tskhvedadzee/ECE-Arcade/Gun-V2/Photos/Final-Print/IMG_3475.jpg

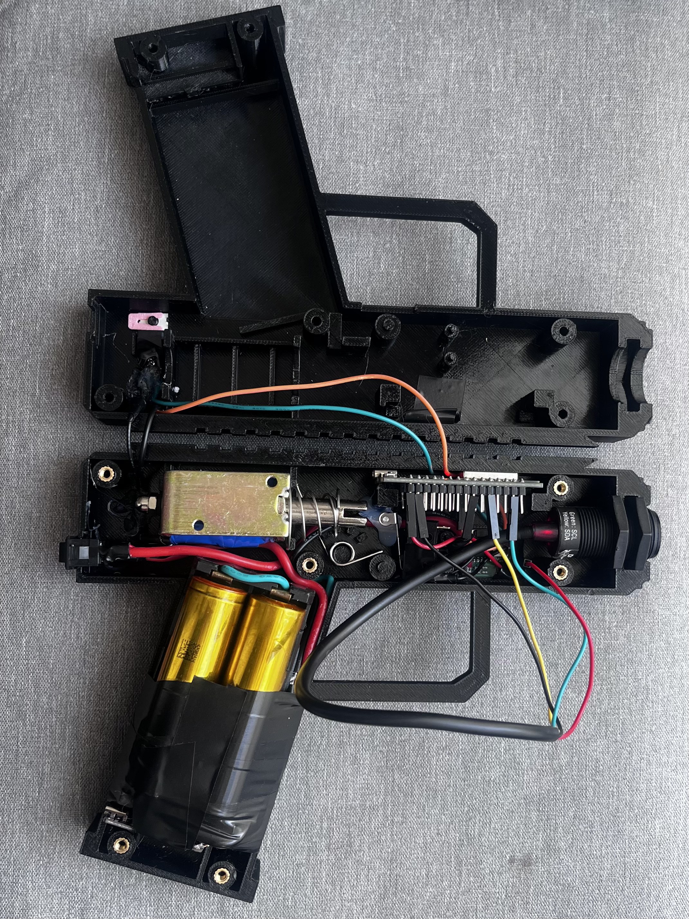
Gun-V2/Photos/Final-Print/IMG_3475.jpg
