tskhvedadzee/ECE-Arcade/README.md

-------------------   ECE Arcade   -------------------
egari raaa
