tskhvedadzee/ECE-Arcade/Cabinet/CAD/Holders/screen-IR-holder-side.SLDASM

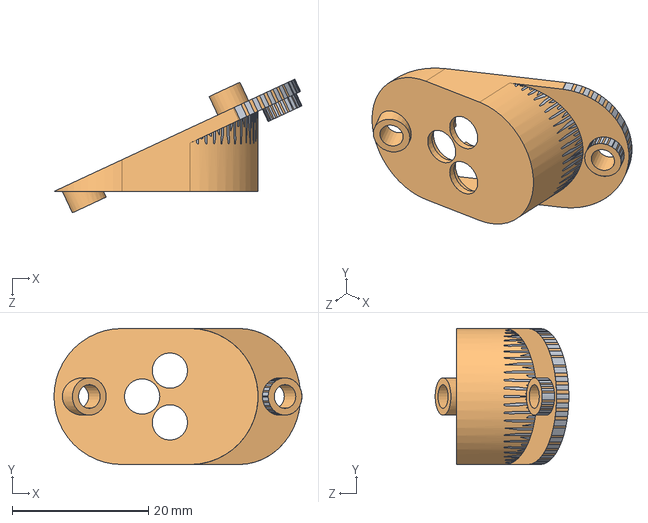
[picture p4: CAD file, 2026-09-12]
Cabinet/CAD/Holders/screen-IR-holder-side.SLDASM
36.5 x 20.0 x 19.7 mm
screen-IR-holder-side-top
screen-IR-holder-side-bottom
