tskhvedadzee/ECE-Arcade/Cabinet/CAD/Body/horn-side.SLDPRT

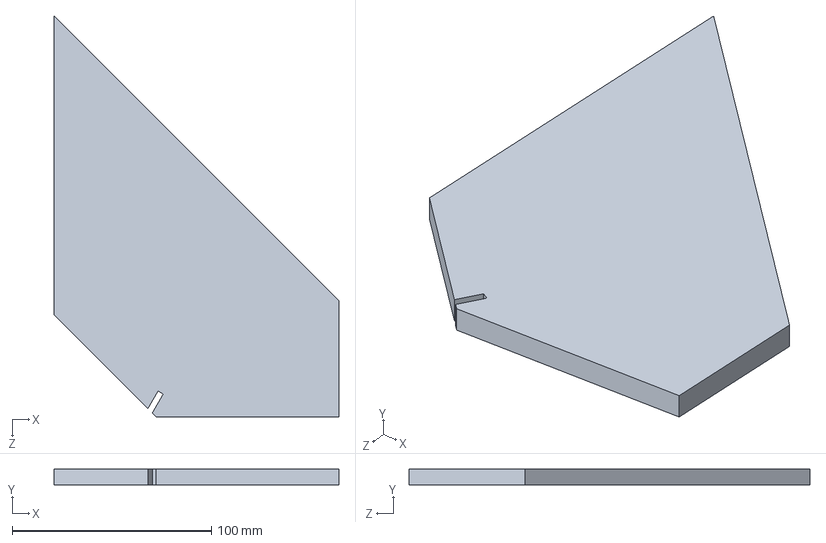
[picture p5: CAD file, 2026-09-12]
Cabinet/CAD/Body/horn-side.SLDPRT
143.1 x 8.00 x 201.3 mm
