tskhvedadzee/ECE-Arcade/Cabinet/CAD/Holders/amp_bracket_long_into_cabinet.step

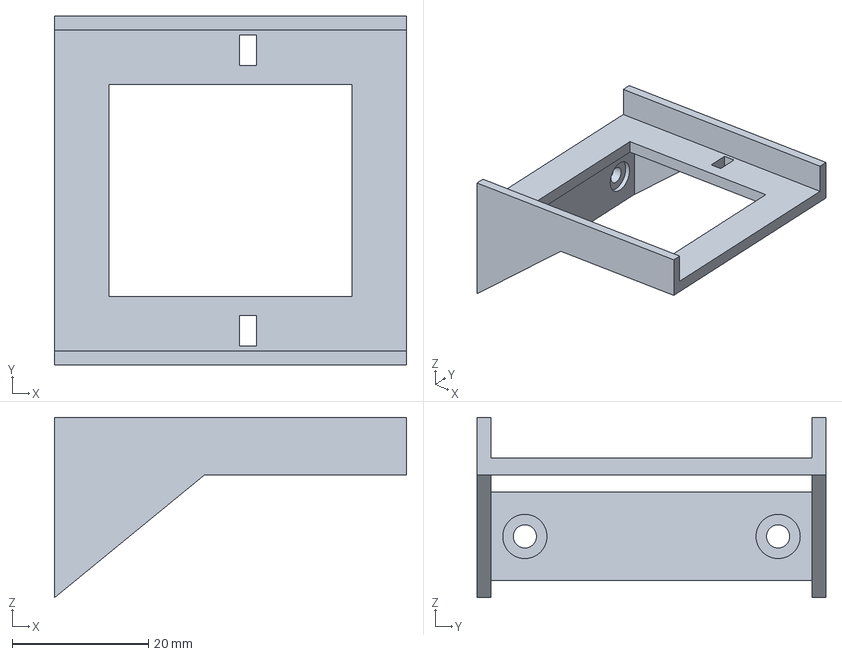
[picture p6: CAD file, 2026-10-04]
Cabinet/CAD/Holders/amp_bracket_long_into_cabinet.step
51.7 x 51.2 x 26.5 mm
