tskhvedadzee/ECE-Arcade/Cabinet/CNC/screen-front-cover-2.DXF

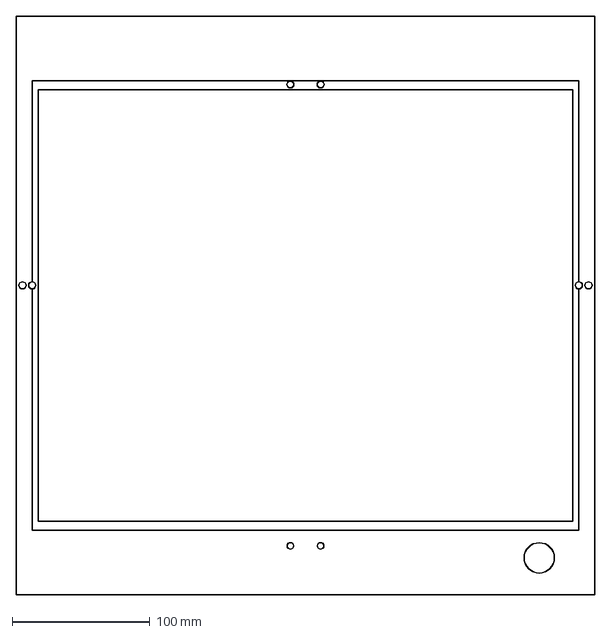
[picture p7: CAD file, 2026-09-12]
Cabinet/CNC/screen-front-cover-2.DXF
420.0 x 420.0 mm
