tskhvedadzee/ECE-Arcade/Cabinet/Laser/dxf/screen-mount.DXF

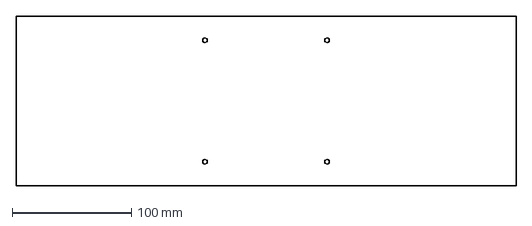
[picture p8: CAD file, 2026-08-28]
Cabinet/Laser/dxf/screen-mount.DXF
420.0 x 142.0 mm
