tskhvedadzee/ECE-Arcade/Cabinet/Printing/potentiometer-knob.3MF

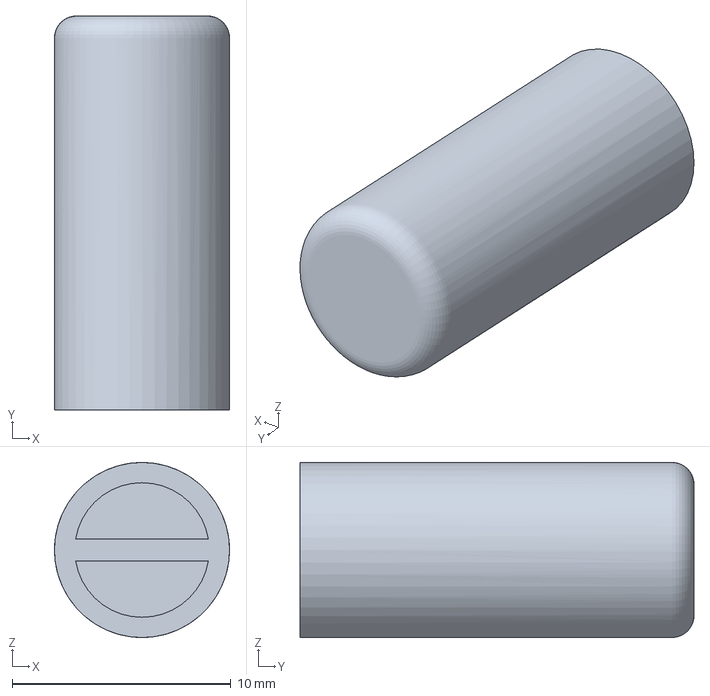
[picture p9: CAD file, 2026-09-21]
Cabinet/Printing/potentiometer-knob.3MF
8.00 x 18.0 x 8.00 mm
