tskhvedadzee/ECE-Arcade/Gun-V2/CAD/Test/test_insert.stl

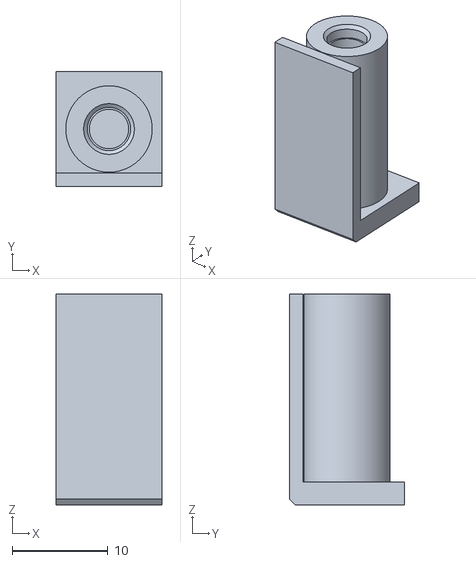
[picture p11: CAD file, 2026-09-23]
Gun-V2/CAD/Test/test_insert.stl
11.0 x 12.0 x 22.0
