tskhvedadzee/ECE-Arcade/Cabinet/CAD/Body/screen-front-cover.SLDPRT

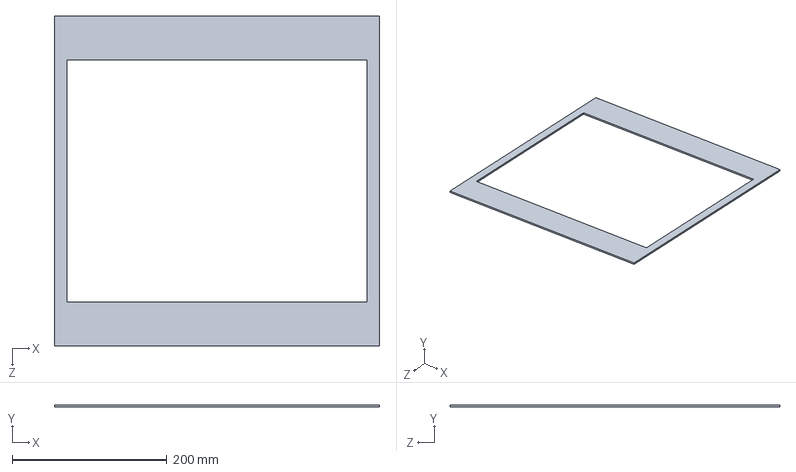
[picture p12: CAD file, 2026-09-12]
Cabinet/CAD/Body/screen-front-cover.SLDPRT
420.0 x 3.00 x 426.0 mm
