tskhvedadzee/ECE-Arcade/Cabinet/CAD/C14-power-socket-male.SLDPRT

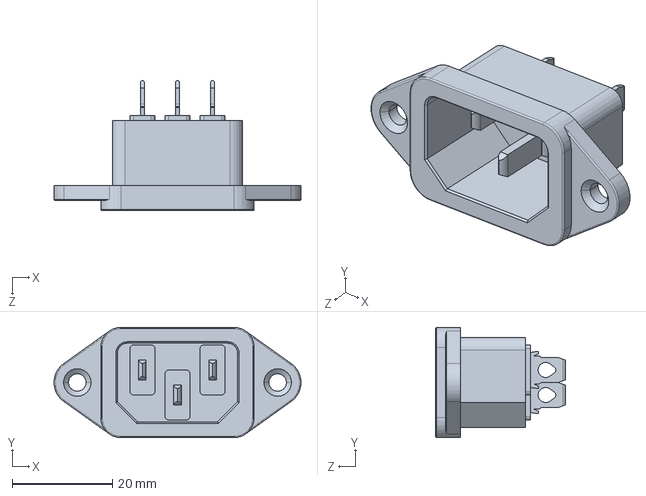
[picture p13: CAD file, 2026-08-11]
Cabinet/CAD/C14-power-socket-male.SLDPRT
49.3 x 22.0 x 26.0 mm
