tskhvedadzee/ECE-Arcade/Cabinet/CAD/Holders/amp_bracket_long_across.step

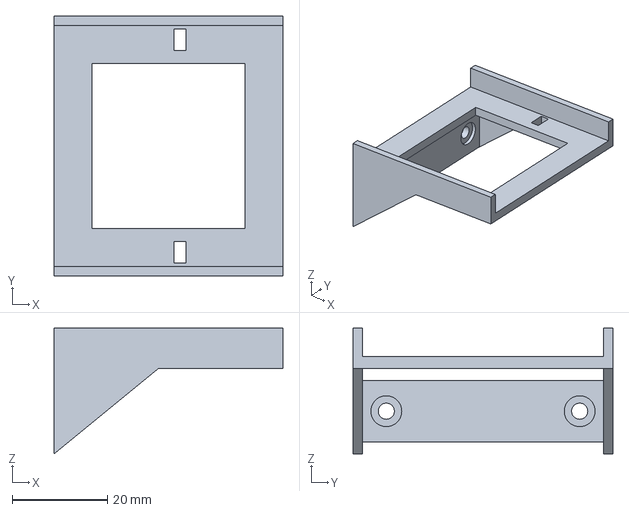
[picture p14: CAD file, 2026-10-04]
Cabinet/CAD/Holders/amp_bracket_long_across.step
48.2 x 54.7 x 26.5 mm
