tskhvedadzee/ECE-Arcade/Cabinet/CNC/front-top.SLDPRT.DXF

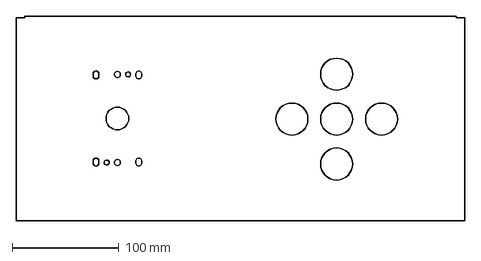
[picture p15: CAD file, 2026-08-31]
Cabinet/CNC/front-top.SLDPRT.DXF
420.0 x 191.2 mm
