tskhvedadzee/ECE-Arcade/Cabinet/Laser/dxf/bottom.DXF

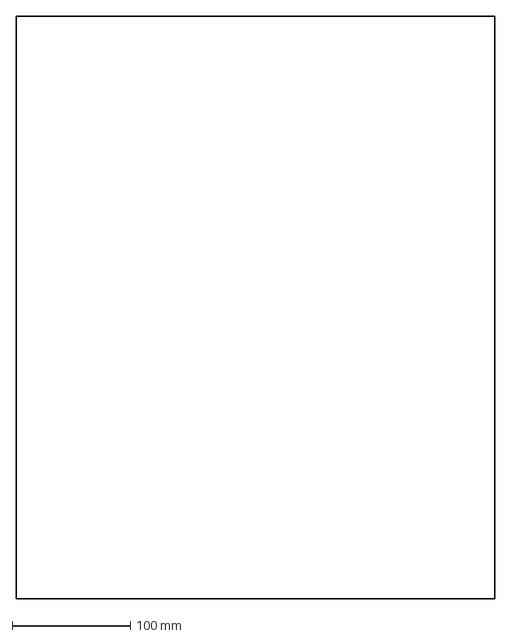
[picture p16: CAD file, 2026-08-28]
Cabinet/Laser/dxf/bottom.DXF
404.0 x 492.0 mm
