tskhvedadzee/ECE-Arcade/Cabinet/Printing/magnet-holder-outer.3MF

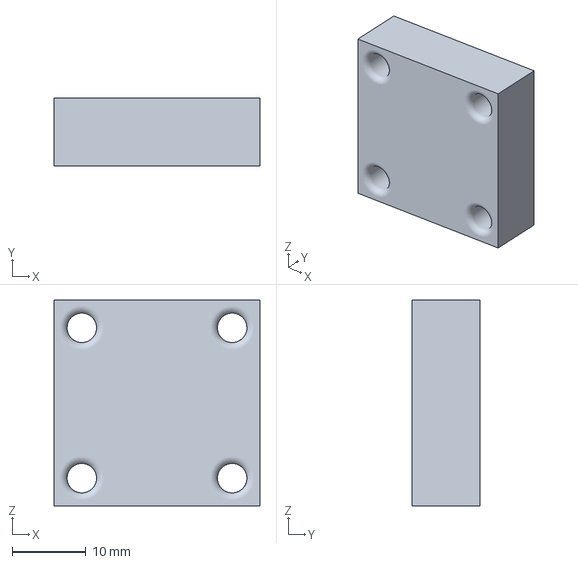
[picture p17: CAD file, 2026-09-21]
Cabinet/Printing/magnet-holder-outer.3MF
28.0 x 9.20 x 28.0 mm
