tskhvedadzee/ECE-Arcade/Gun-V2/CAD/STEP/gun_right_half.step

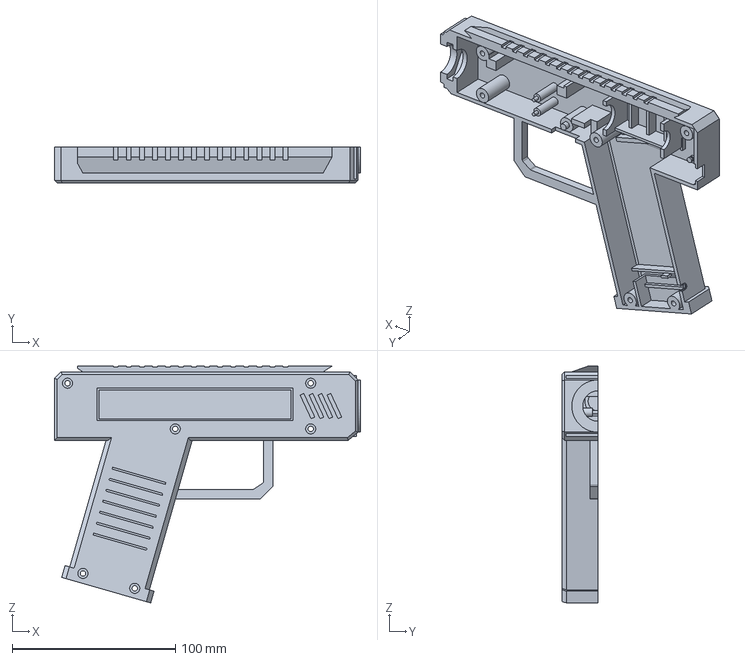
[picture p18: CAD file, 2026-09-23]
Gun-V2/CAD/STEP/gun_right_half.step
187.5 x 22.0 x 145.1 mm
