tskhvedadzee/ECE-Arcade/Gun-V2/CAD/Test/fit_test_mosfet.stl

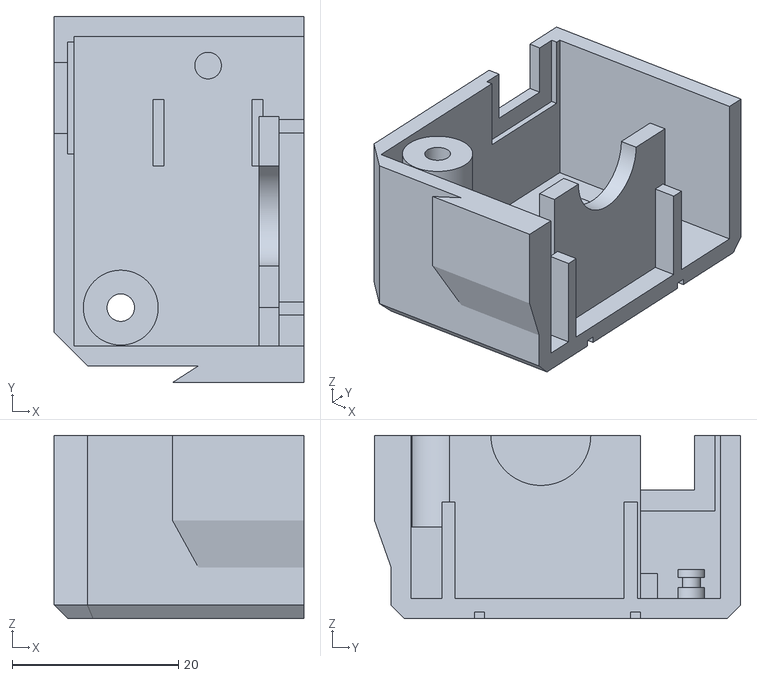
[picture p19: CAD file, 2026-09-23]
Gun-V2/CAD/Test/fit_test_mosfet.stl
30.0 x 44.0 x 22.0
