tskhvedadzee/ECE-Arcade/Cabinet/CAD/Holders/screen-IR-holder-horizontal.SLDPRT

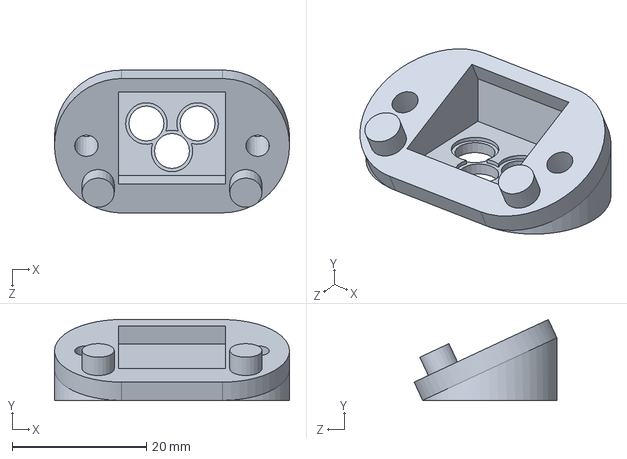
[picture p20: CAD file, 2026-09-21]
Cabinet/CAD/Holders/screen-IR-holder-horizontal.SLDPRT
35.0 x 12.1 x 21.3 mm
