tskhvedadzee/ECE-Arcade/Cabinet/CAD/push-button-switch-22mm.SLDPRT

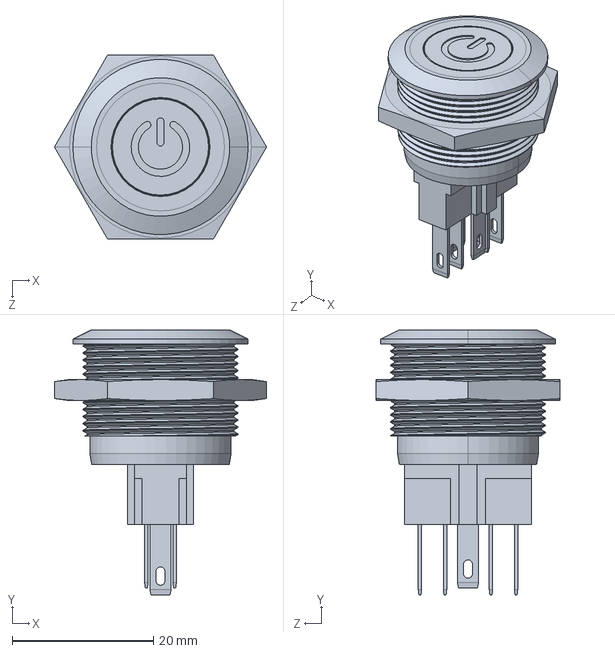
[picture p21: CAD file, 2026-08-11]
Cabinet/CAD/push-button-switch-22mm.SLDPRT
30.0 x 37.5 x 26.0 mm
