tskhvedadzee/ECE-Arcade/Cabinet/CNC/front-top-v2.dxf

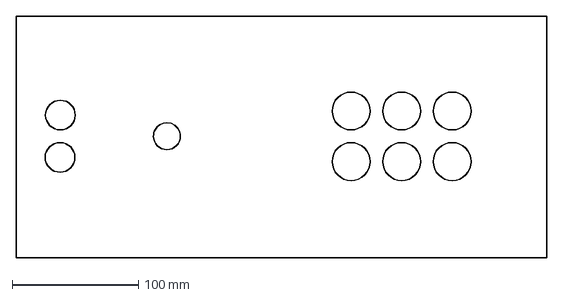
[picture p22: CAD file, 2026-08-31]
Cabinet/CNC/front-top-v2.dxf
420.0 x 191.2 mm
