tskhvedadzee/ECE-Arcade/Cabinet/Laser/dxf/horn-bottom.DXF

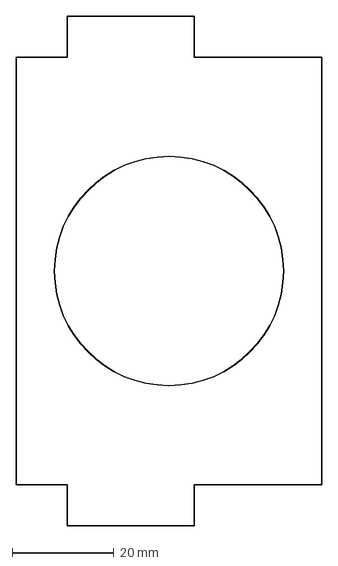
[picture p23: CAD file, 2026-08-28]
Cabinet/Laser/dxf/horn-bottom.DXF
60.0 x 100.0 mm
