tskhvedadzee/ECE-Arcade/Cabinet/Printing/magnet-holder-inner.3MF

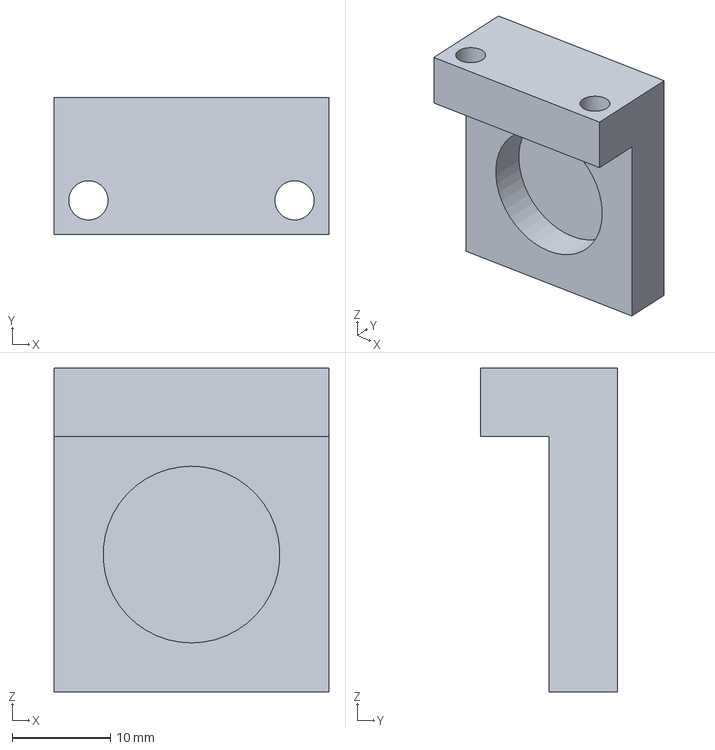
[picture p24: CAD file, 2026-09-21]
Cabinet/Printing/magnet-holder-inner.3MF
28.0 x 14.0 x 33.0 mm
