tskhvedadzee/ECE-Arcade/Gun-V2/CAD/Test/fit_test_buck.stl

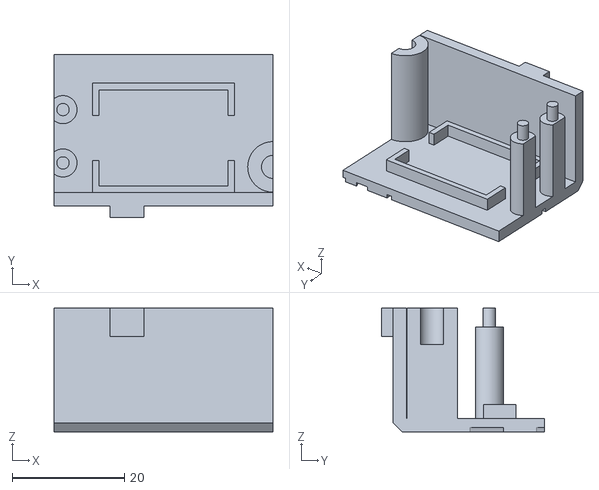
[picture p25: CAD file, 2026-09-23]
Gun-V2/CAD/Test/fit_test_buck.stl
39.0 x 29.0 x 22.0
