tskhvedadzee/ECE-Arcade/Cabinet/CAD/Body/side.SLDPRT

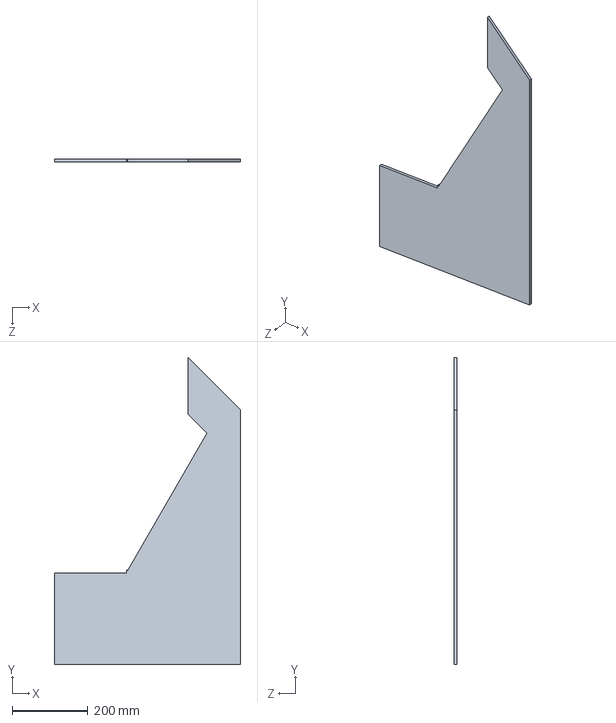
[picture p26: CAD file, 2026-09-12]
Cabinet/CAD/Body/side.SLDPRT
492.0 x 810.4 x 8.00 mm
