tskhvedadzee/ECE-Arcade/Cabinet/CNC/side.DXF

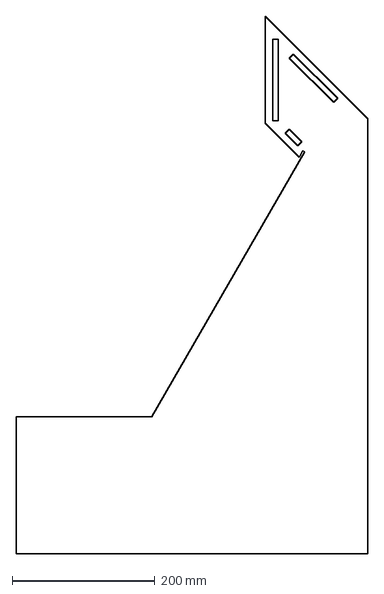
[picture p27: CAD file, 2026-08-28]
Cabinet/CNC/side.DXF
492.0 x 752.2 mm
