tskhvedadzee/ECE-Arcade/Cabinet/Laser/dxf/front.DXF

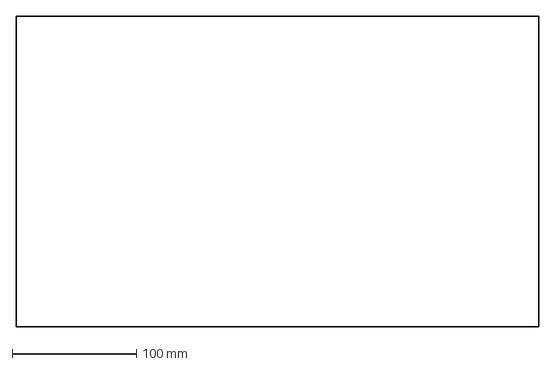
[picture p28: CAD file, 2026-08-28]
Cabinet/Laser/dxf/front.DXF
420.0 x 250.0 mm
