tskhvedadzee/ECE-Arcade/Cabinet/Printing/screen-IR-holder-horizontal.3MF

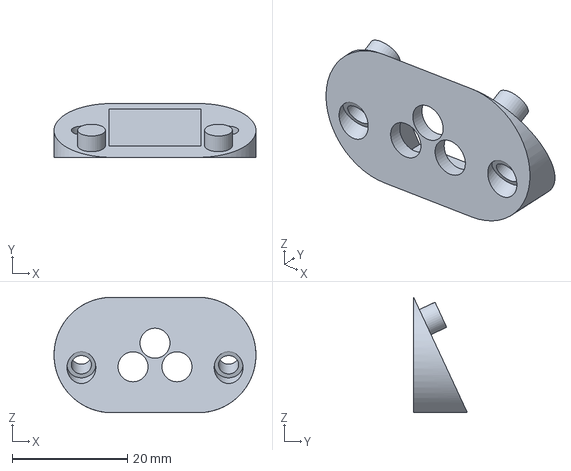
[picture p29: CAD file, 2026-09-12]
Cabinet/Printing/screen-IR-holder-horizontal.3MF
35.0 x 9.34 x 20.0 mm
