tskhvedadzee/ECE-Arcade/Gun-V2/CAD/STEP/mosfet_clip.step

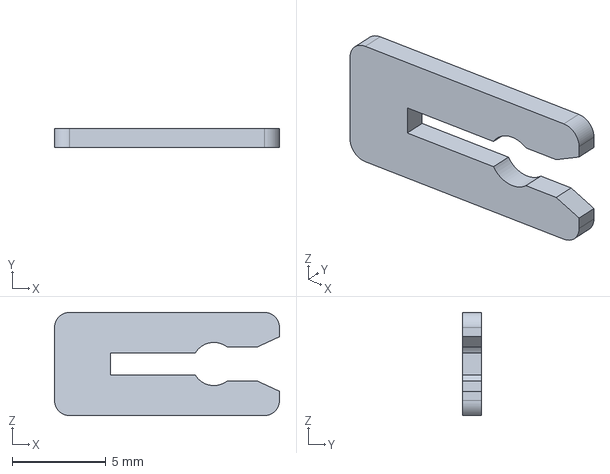
[picture p30: CAD file, 2026-09-23]
Gun-V2/CAD/STEP/mosfet_clip.step
12.0 x 1.00 x 5.50 mm
