tskhvedadzee/ECE-Arcade/Cabinet/CAD/Body/front-top.SLDPRT

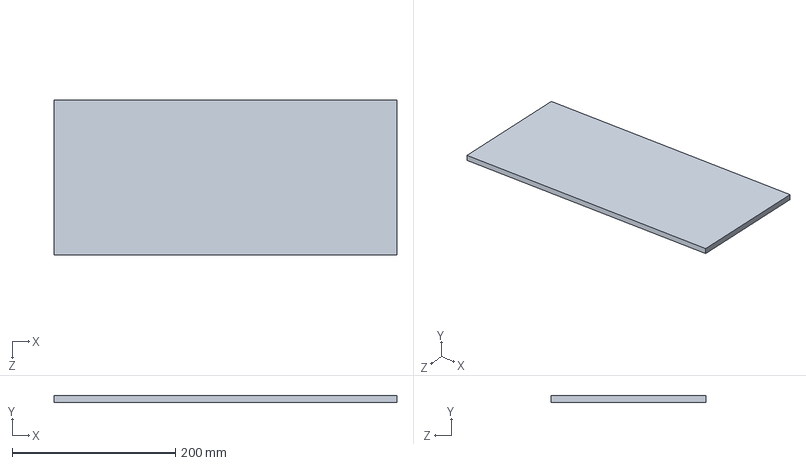
[picture p32: CAD file, 2026-09-12]
Cabinet/CAD/Body/front-top.SLDPRT
420.0 x 8.00 x 190.0 mm
