tskhvedadzee/ECE-Arcade/Cabinet/CAD/Holders/screen-IR-holder-side-top.SLDPRT

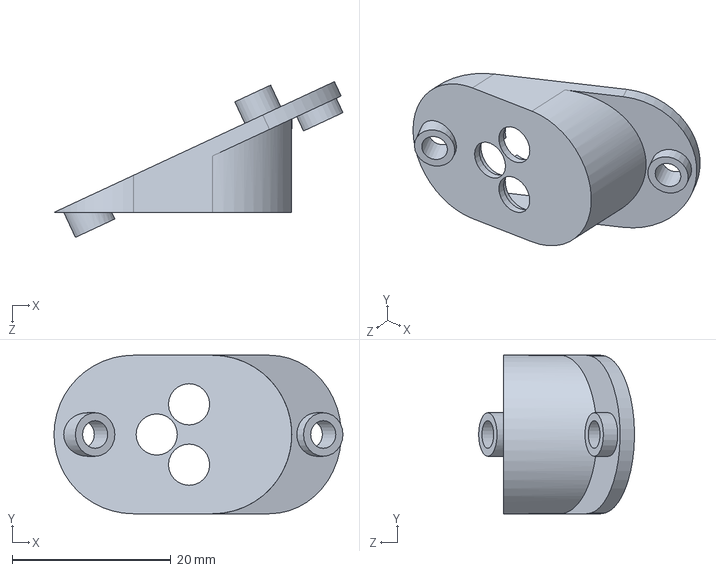
[picture p33: CAD file, 2026-09-12]
Cabinet/CAD/Holders/screen-IR-holder-side-top.SLDPRT
36.5 x 20.0 x 19.7 mm
