tskhvedadzee/ECE-Arcade/Cabinet/CNC/side-split-bottom-2.dxf

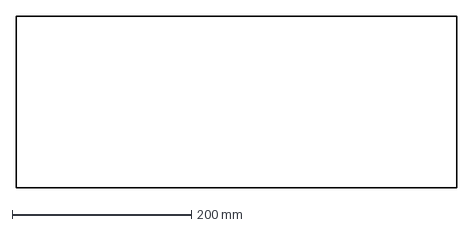
[picture p34: CAD file, 2026-08-28]
Cabinet/CNC/side-split-bottom-2.dxf
492.0 x 192.0 mm
