tskhvedadzee/ECE-Arcade/Cabinet/Laser/dxf/top.DXF

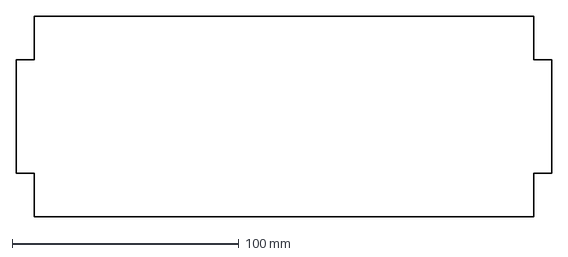
[picture p35: CAD file, 2026-08-28]
Cabinet/Laser/dxf/top.DXF
236.0 x 88.2 mm
