tskhvedadzee/ECE-Arcade/Gun-V2/CAD/Test/fit_test_esp32_left.stl

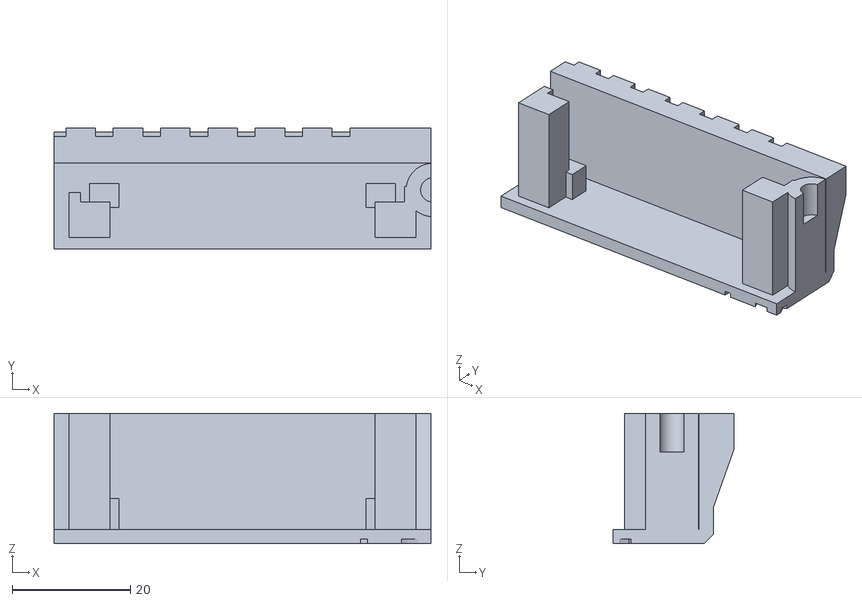
[picture p36: CAD file, 2026-09-21]
Gun-V2/CAD/Test/fit_test_esp32_left.stl
63.7 x 20.5 x 22.0
