tskhvedadzee/ECE-Arcade/Cabinet/CAD/Body/back.SLDPRT

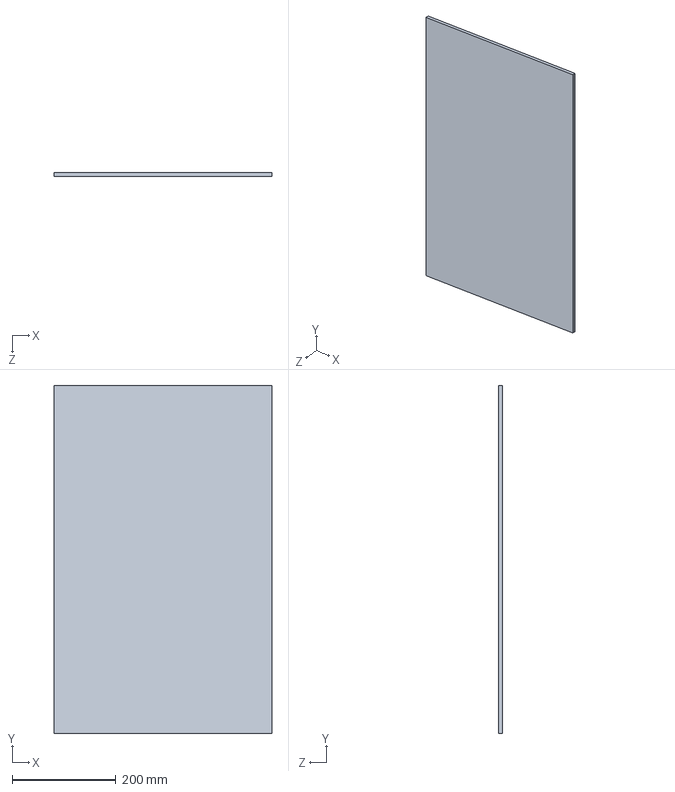
[picture p37: CAD file, 2026-08-28]
Cabinet/CAD/Body/back.SLDPRT
420.0 x 672.0 x 8.00 mm
