tskhvedadzee/ECE-Arcade/Cabinet/CAD/Holders/screen-IR-holder-side-bottom.SLDPRT

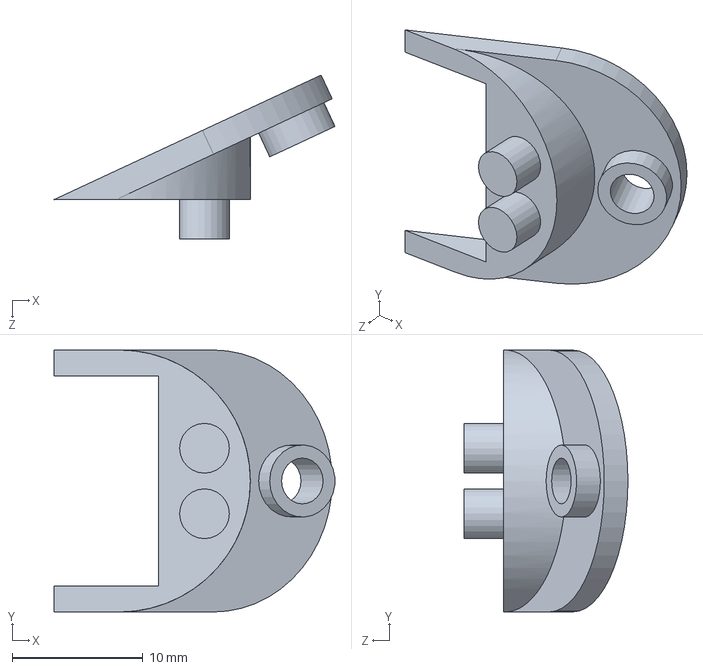
[picture p38: CAD file, 2026-09-12]
Cabinet/CAD/Holders/screen-IR-holder-side-bottom.SLDPRT
21.5 x 20.0 x 12.5 mm
