tskhvedadzee/ECE-Arcade/Cabinet/CNC/front-front.DXF

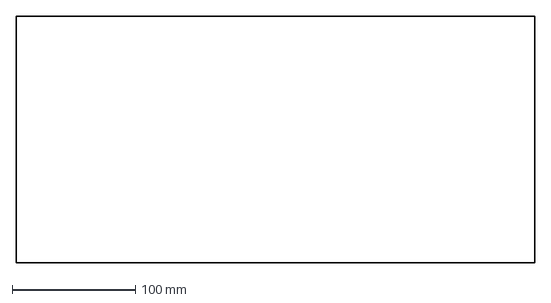
[picture p39: CAD file, 2026-08-28]
Cabinet/CNC/front-front.DXF
420.0 x 200.0 mm
