tskhvedadzee/ECE-Arcade/Cabinet/Laser/dxf/screen-cover.DXF

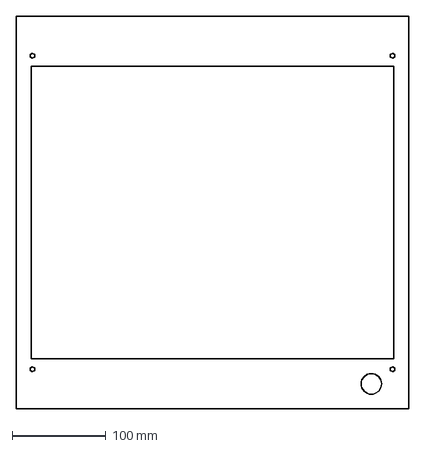
[picture p40: CAD file, 2026-08-28]
Cabinet/Laser/dxf/screen-cover.DXF
420.0 x 420.0 mm
