tskhvedadzee/ECE-Arcade/Cabinet/Printing/wire-clip-4x.3MF

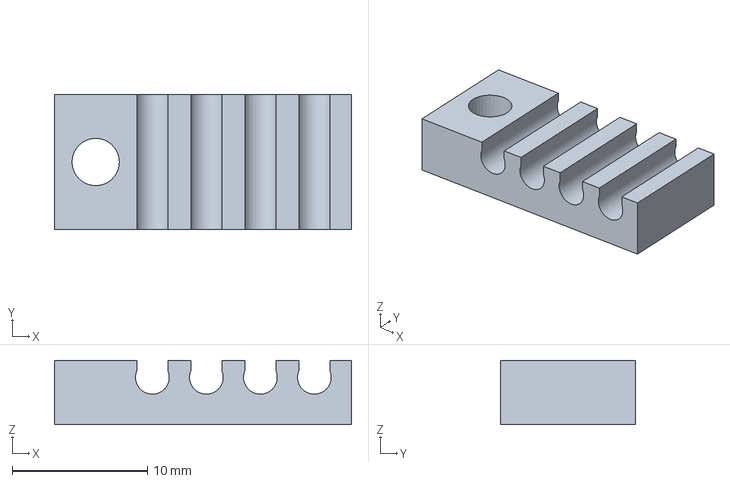
[picture p41: CAD file, 2026-08-31]
Cabinet/Printing/wire-clip-4x.3MF
22.0 x 10.0 x 4.75 mm
