tskhvedadzee/ECE-Arcade/Cabinet/CAD/Body/screen-mount.SLDPRT

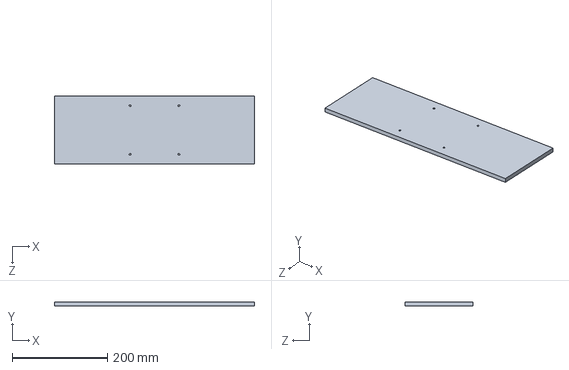
[picture p42: CAD file, 2026-08-28]
Cabinet/CAD/Body/screen-mount.SLDPRT
420.0 x 8.00 x 142.0 mm
