tskhvedadzee/ECE-Arcade/Cabinet/CNC/side-split-bottom.dxf

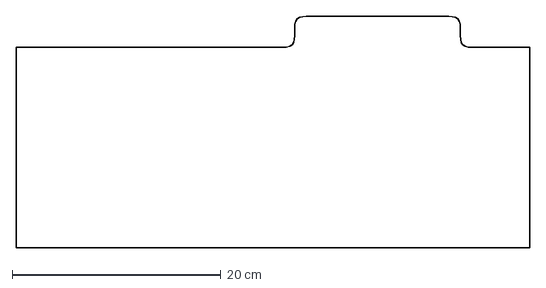
[picture p43: CAD file, 2026-08-28]
Cabinet/CNC/side-split-bottom.dxf
49.2 x 22.2 cm
