tskhvedadzee/ECE-Arcade/Cabinet/Laser/dxf/top-back.DXF

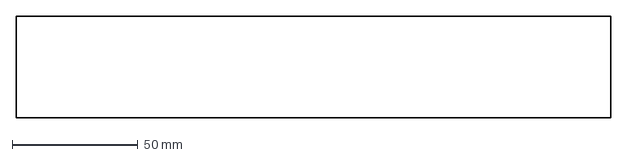
[picture p44: CAD file, 2026-08-28]
Cabinet/Laser/dxf/top-back.DXF
236.0 x 40.3 mm
