tskhvedadzee/ECE-Arcade/Cabinet/Printing/buck-holder.3MF

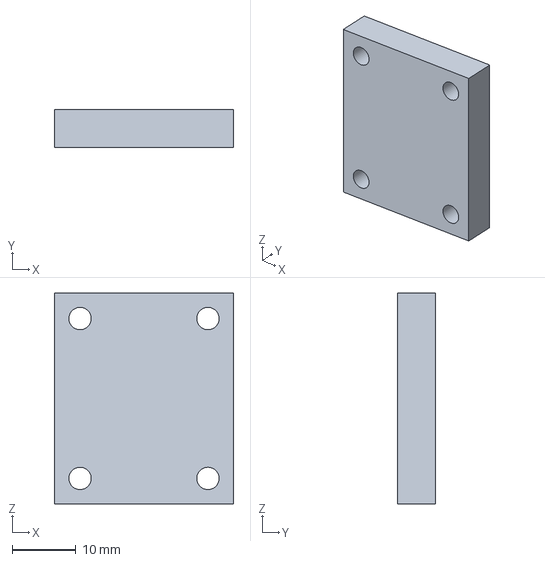
[picture p45: CAD file, 2026-08-31]
Cabinet/Printing/buck-holder.3MF
28.0 x 6.00 x 33.0 mm
