tskhvedadzee/ECE-Arcade/Cabinet/CAD/Body/front-front.SLDPRT

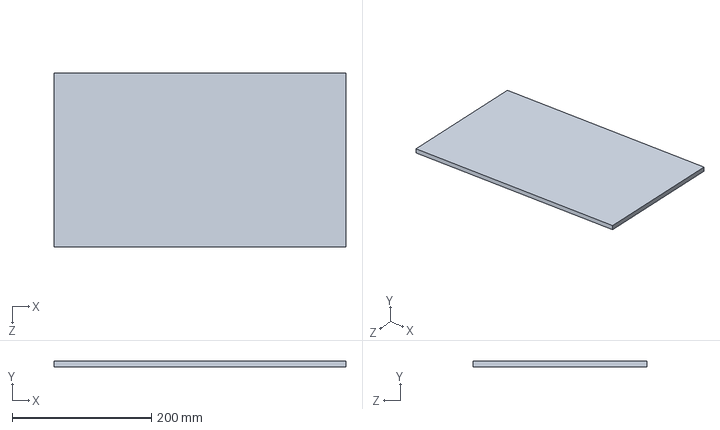
[picture p47: CAD file, 2026-08-28]
Cabinet/CAD/Body/front-front.SLDPRT
420.0 x 8.00 x 250.0 mm
