tskhvedadzee/ECE-Arcade/Cabinet/CAD/Holders/wire-clip-2x.SLDPRT

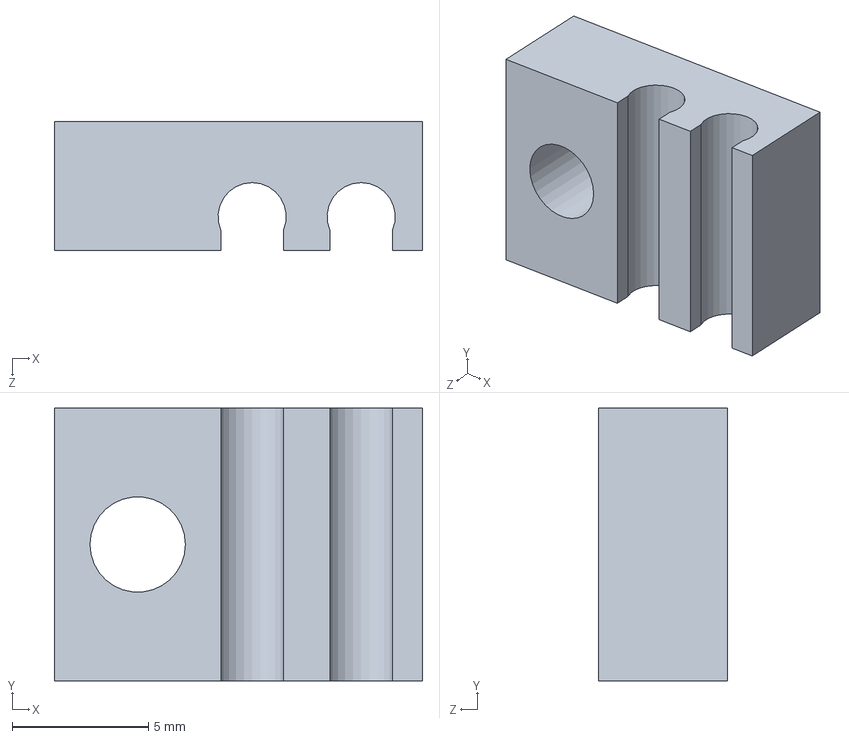
[picture p48: CAD file, 2026-08-31]
Cabinet/CAD/Holders/wire-clip-2x.SLDPRT
13.5 x 10.0 x 4.75 mm
