tskhvedadzee/ECE-Arcade/Cabinet/CNC/side-split-top-two.dxf

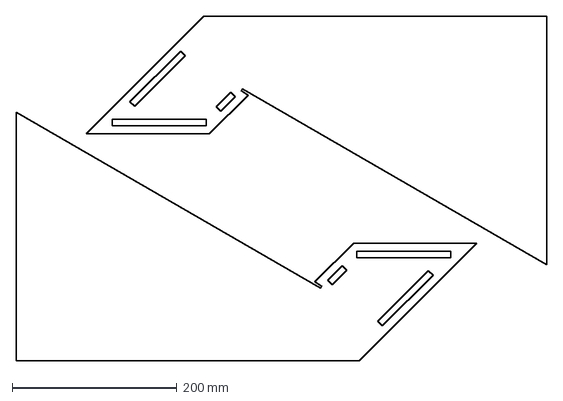
[picture p49: CAD file, 2026-08-28]
Cabinet/CNC/side-split-top-two.dxf
645.2 x 419.1 mm
