tskhvedadzee/ECE-Arcade/Cabinet/Laser/dxf/side.DXF

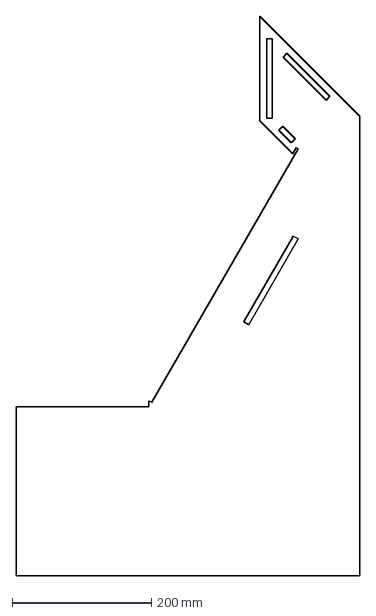
[picture p50: CAD file, 2026-08-28]
Cabinet/Laser/dxf/side.DXF
492.0 x 802.2 mm
