tskhvedadzee/ECE-Arcade/Gun-V2/CAD/Test/fit_test_butt_left.stl

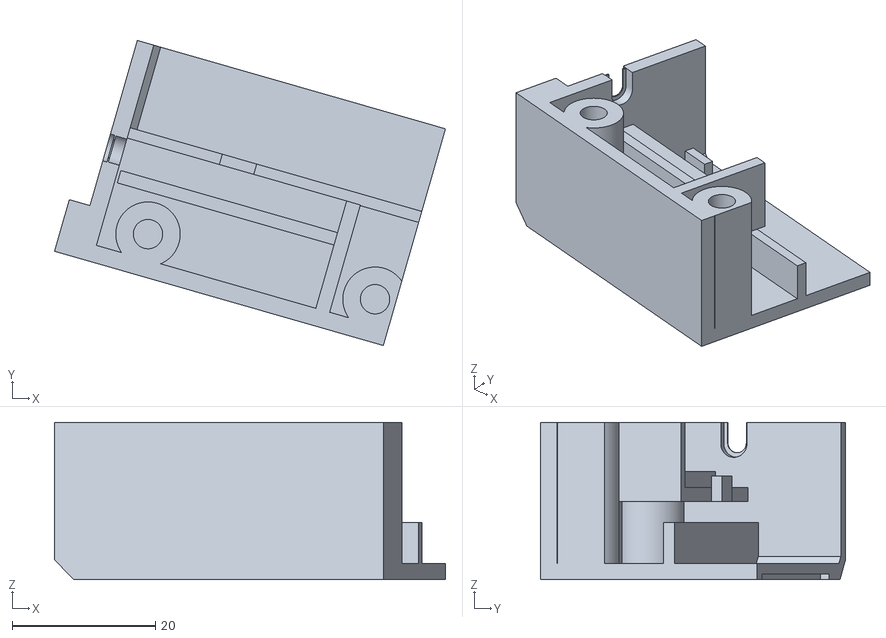
[picture p51: CAD file, 2026-09-21]
Gun-V2/CAD/Test/fit_test_butt_left.stl
54.6 x 42.6 x 22.0
