tskhvedadzee/ECE-Arcade/Cabinet/CAD/Body/top.SLDPRT

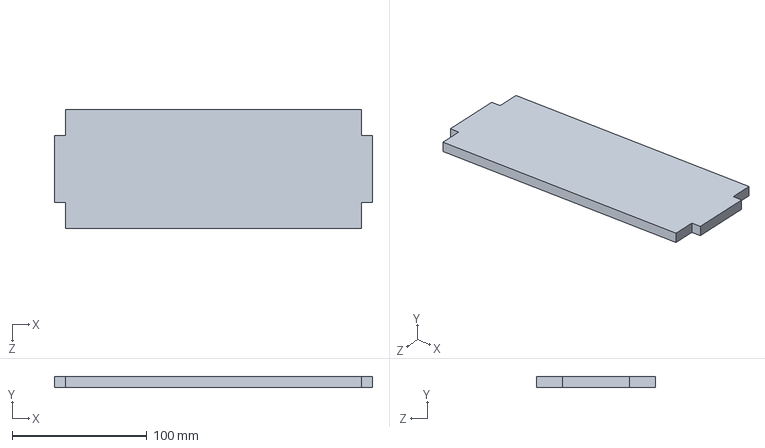
[picture p52: CAD file, 2026-08-11]
Cabinet/CAD/Body/top.SLDPRT
236.0 x 8.00 x 88.2 mm
