tskhvedadzee/ECE-Arcade/Cabinet/CAD/Holders/wire-clip-8x.SLDPRT

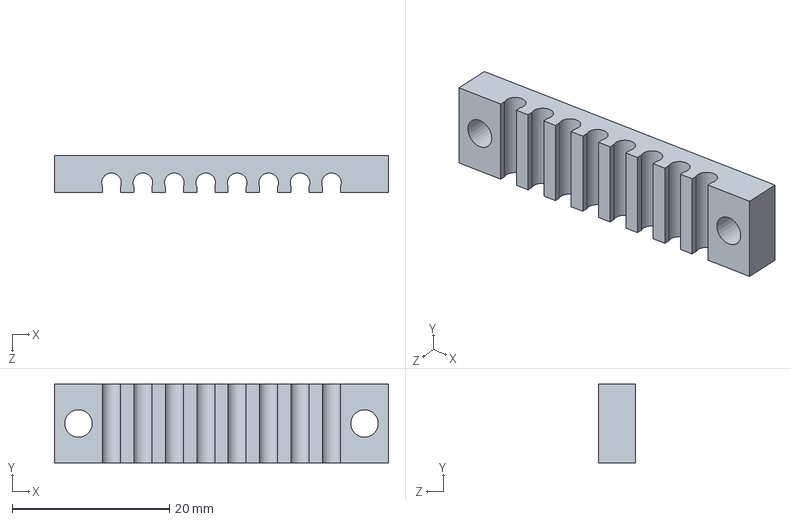
[picture p53: CAD file, 2026-08-31]
Cabinet/CAD/Holders/wire-clip-8x.SLDPRT
42.5 x 10.0 x 4.75 mm
