tskhvedadzee/ECE-Arcade/Cabinet/CNC/horn-top.DXF

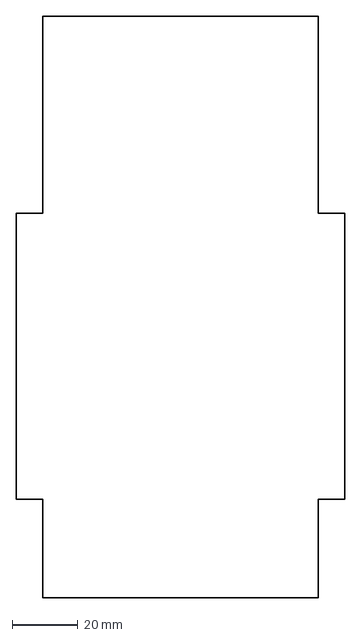
[picture p54: CAD file, 2026-08-28]
Cabinet/CNC/horn-top.DXF
100.0 x 177.2 mm
