tskhvedadzee/ECE-Arcade/Cabinet/Laser/dxf/horn-front.DXF

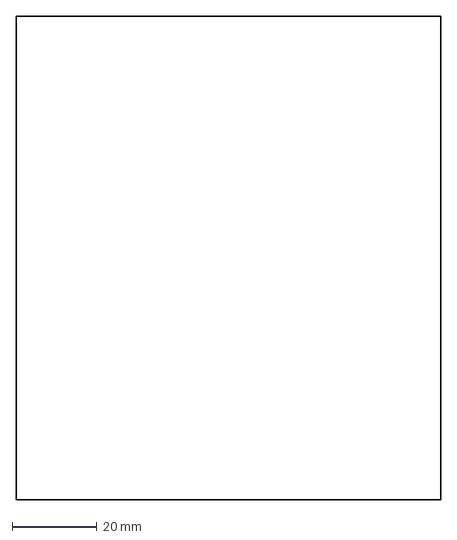
[picture p55: CAD file, 2026-08-28]
Cabinet/Laser/dxf/horn-front.DXF
100.0 x 113.9 mm
