tskhvedadzee/ECE-Arcade/Gun-V2/CAD/STEP/trigger.step

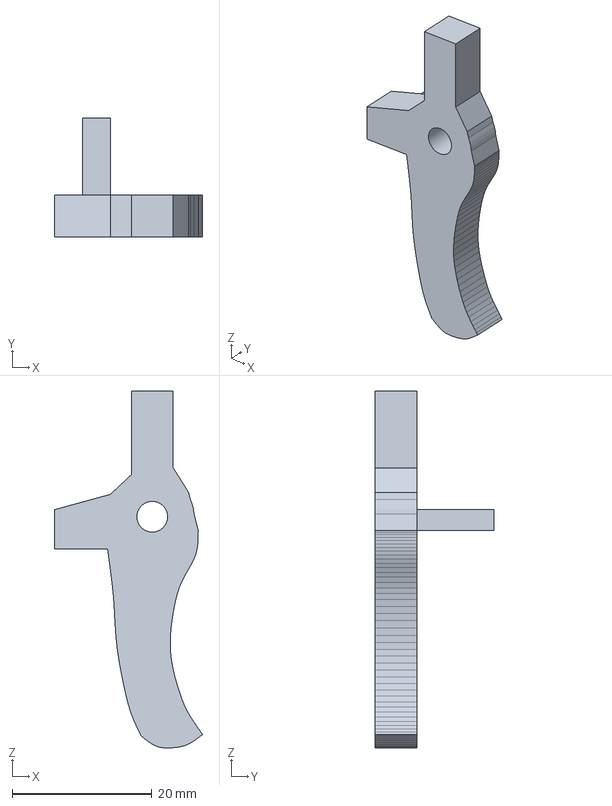
[picture p56: CAD file, 2026-09-12]
Gun-V2/CAD/STEP/trigger.step
21.2 x 17.0 x 51.1 mm
