tskhvedadzee/ECE-Arcade/Gun-V2/CAD/Test/fit_test_trigger_left.stl

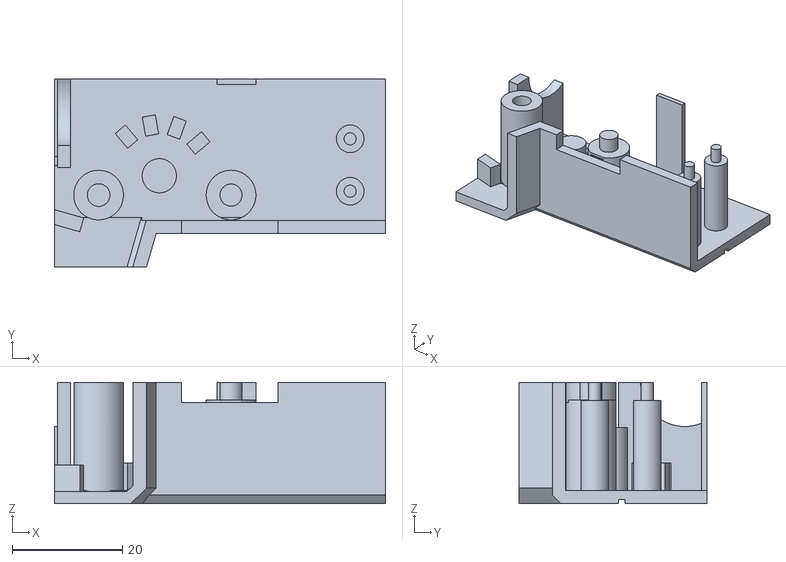
[picture p57: CAD file, 2026-09-21]
Gun-V2/CAD/Test/fit_test_trigger_left.stl
60.0 x 34.0 x 22.0
