tskhvedadzee/ECE-Arcade/Cabinet/CAD/Body/top-back.SLDPRT

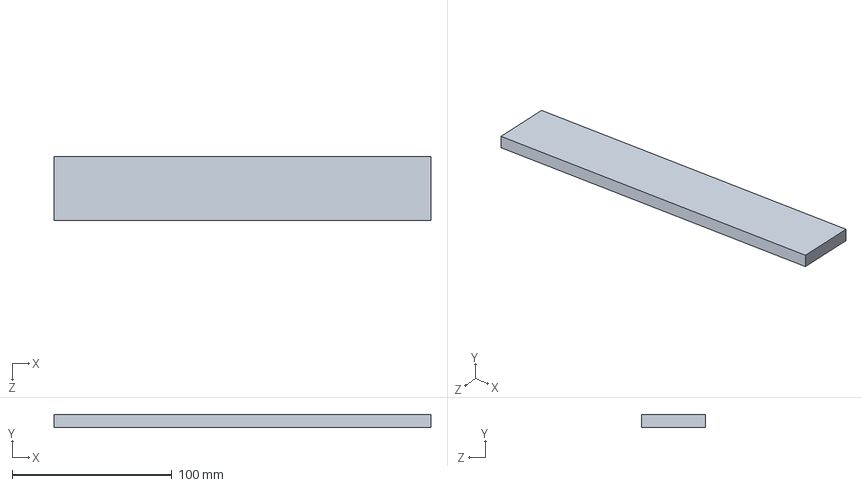
[picture p58: CAD file, 2026-08-11]
Cabinet/CAD/Body/top-back.SLDPRT
236.0 x 8.00 x 40.3 mm
