tskhvedadzee/ECE-Arcade/Cabinet/CNC/horn-front.DXF

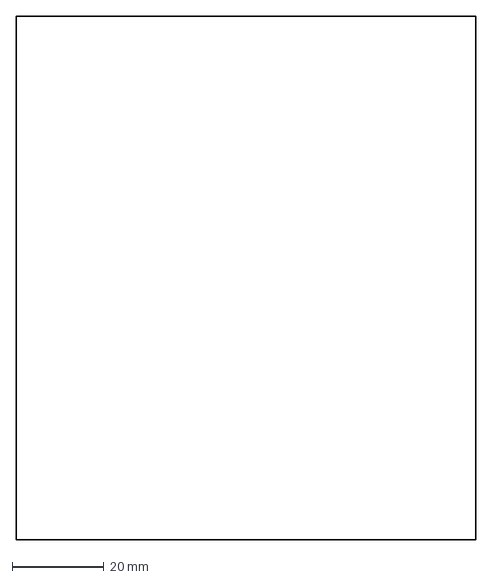
[picture p59: CAD file, 2026-08-28]
Cabinet/CNC/horn-front.DXF
100.0 x 113.9 mm
