tskhvedadzee/ECE-Arcade/Cabinet/Laser/dxf/horn-top.DXF

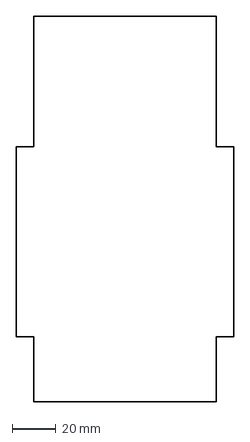
[picture p60: CAD file, 2026-08-28]
Cabinet/Laser/dxf/horn-top.DXF
100.0 x 177.2 mm
