tskhvedadzee/ECE-Arcade/Cabinet/Printing/raspberry-holder-bottom.stl

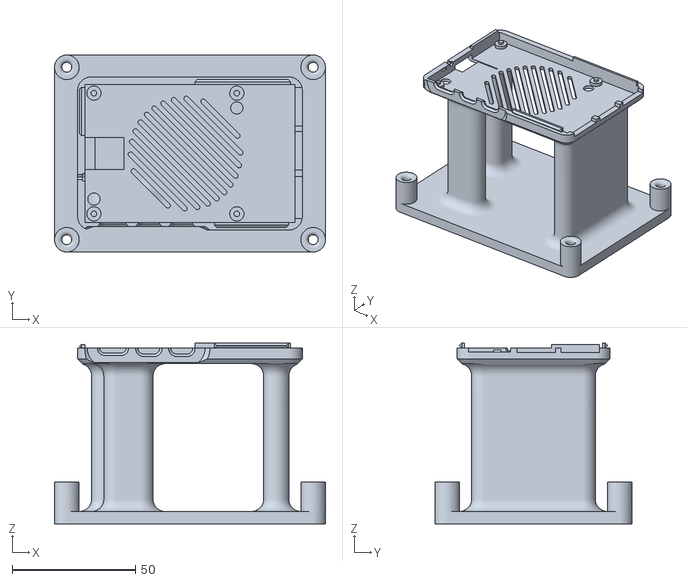
[picture p61: CAD file, 2026-08-31]
Cabinet/Printing/raspberry-holder-bottom.stl
110.0 x 80.0 x 73.3
