tskhvedadzee/ECE-Arcade/Gun-V2/CAD/Test/fit_test_front_left.stl

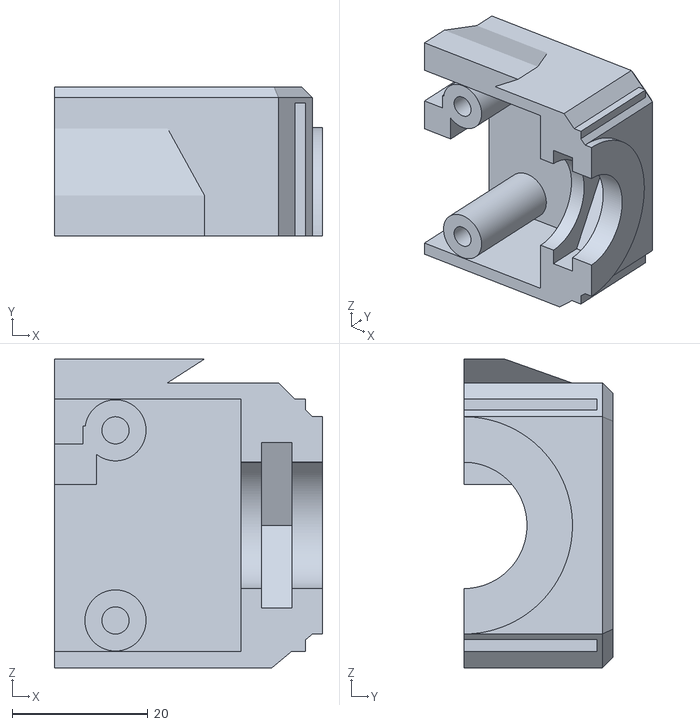
[picture p62: CAD file, 2026-09-12]
Gun-V2/CAD/Test/fit_test_front_left.stl
39.5 x 22.0 x 45.5
