tskhvedadzee/ECE-Arcade/Cabinet/CAD/Body/screen.SLDPRT

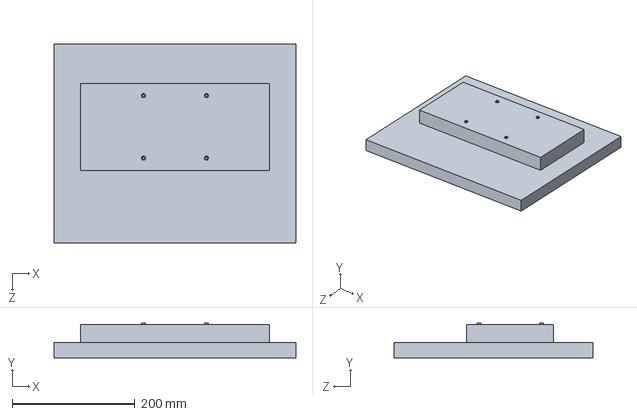
[picture p63: CAD file, 2026-08-11]
Cabinet/CAD/Body/screen.SLDPRT
395.0 x 57.0 x 325.0 mm
