tskhvedadzee/ECE-Arcade/Cabinet/CNC/horn-bottom.DXF

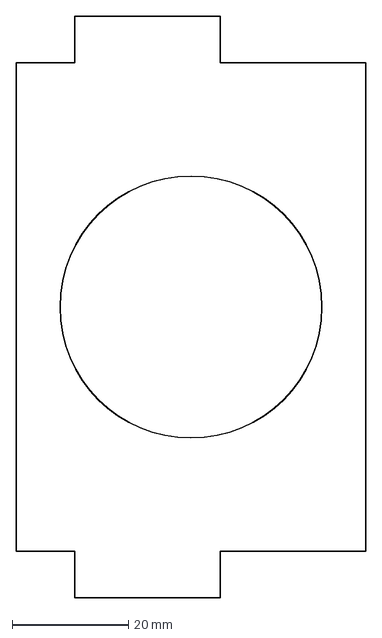
[picture p64: CAD file, 2026-08-28]
Cabinet/CNC/horn-bottom.DXF
60.0 x 100.0 mm
