tskhvedadzee/ECE-Arcade/Cabinet/Laser/dxf/front-top.DXF

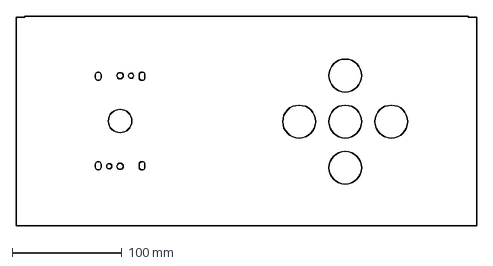
[picture p65: CAD file, 2026-08-28]
Cabinet/Laser/dxf/front-top.DXF
420.0 x 191.2 mm
