tskhvedadzee/ECE-Arcade/Cabinet/Printing/raspberry-holder-top.stl

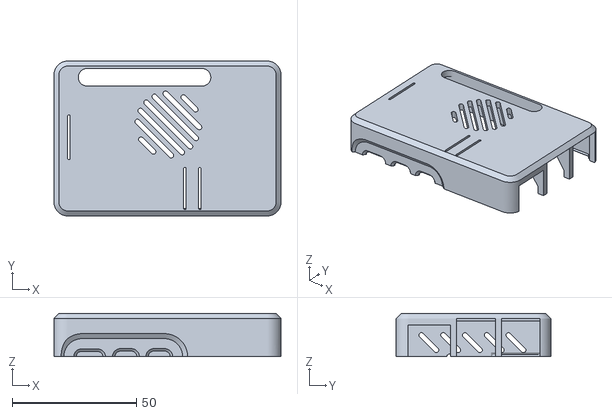
[picture p66: CAD file, 2026-08-31]
Cabinet/Printing/raspberry-holder-top.stl
91.2 x 62.2 x 17.3
