tskhvedadzee/ECE-Arcade/Gun-V2/CAD/Test/fit_test_front_right.stl

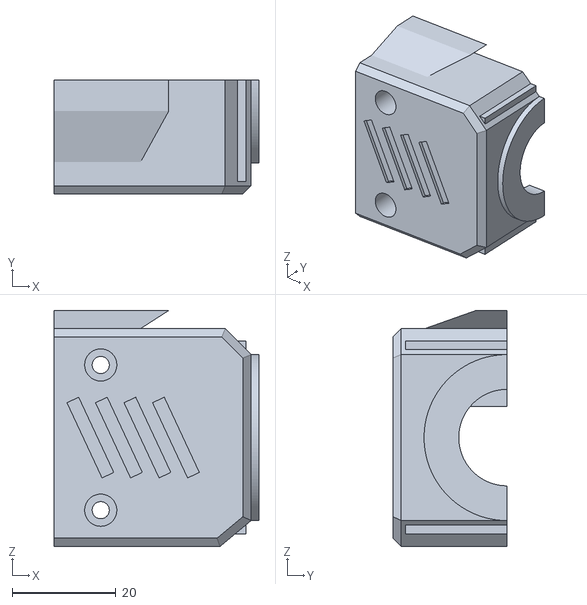
[picture p67: CAD file, 2026-09-12]
Gun-V2/CAD/Test/fit_test_front_right.stl
39.5 x 22.0 x 45.5
