tskhvedadzee/ECE-Arcade/Cabinet/CAD/Body/horn-bottom.SLDPRT

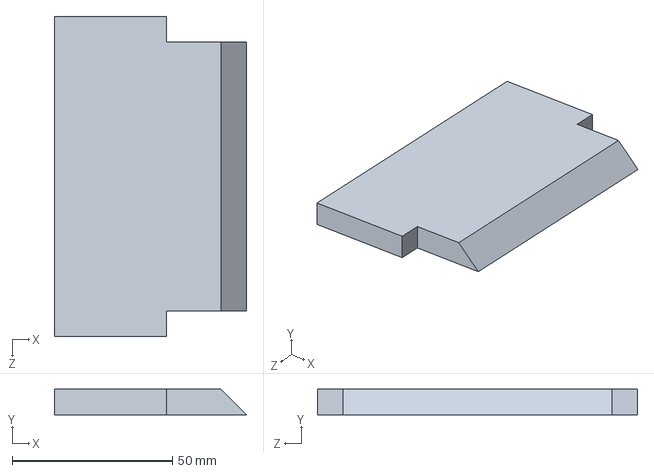
[picture p68: CAD file, 2026-08-11]
Cabinet/CAD/Body/horn-bottom.SLDPRT
60.0 x 8.00 x 100.0 mm
