tskhvedadzee/ECE-Arcade/Cabinet/CNC/screen-mount.DXF

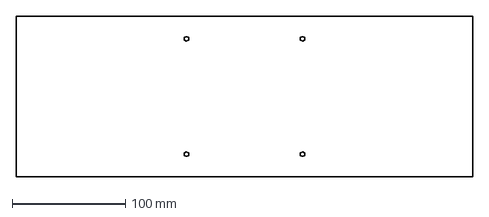
[picture p69: CAD file, 2026-08-28]
Cabinet/CNC/screen-mount.DXF
404.0 x 142.0 mm
