tskhvedadzee/ECE-Arcade/Cabinet/Laser/dxf/back.DXF

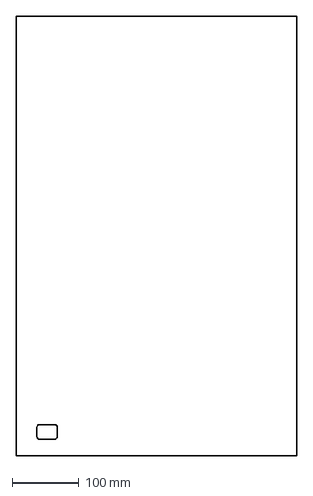
[picture p70: CAD file, 2026-08-28]
Cabinet/Laser/dxf/back.DXF
420.0 x 659.0 mm
