tskhvedadzee/ECE-Arcade/Cabinet/Printing/8mm corner.3MF

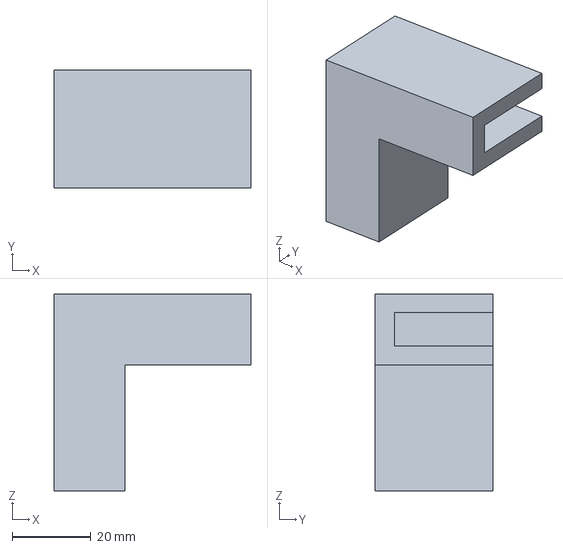
[picture p71: CAD file, 2026-08-28]
Cabinet/Printing/8mm corner.3MF
50.0 x 30.0 x 50.0 mm
