tskhvedadzee/ECE-Arcade/Cabinet/CAD/Body/horn-front.SLDPRT

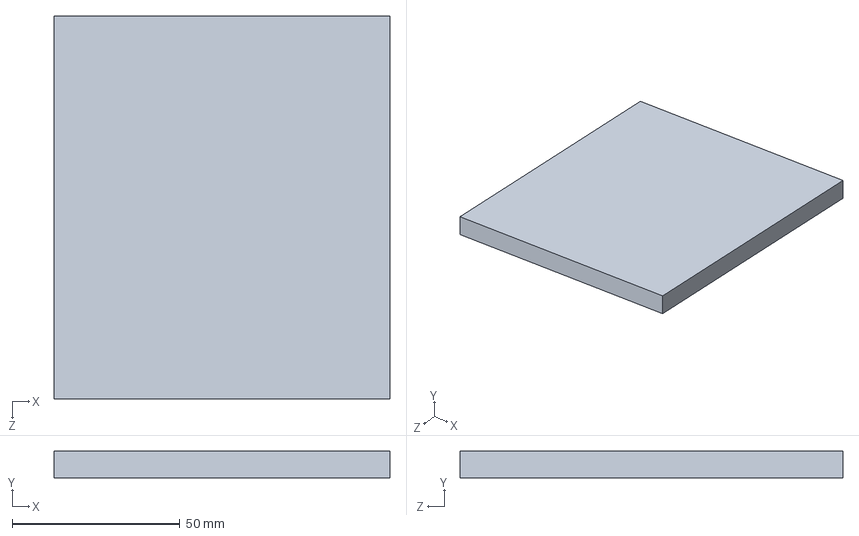
[picture p72: CAD file, 2026-08-11]
Cabinet/CAD/Body/horn-front.SLDPRT
100.0 x 8.00 x 113.9 mm
