tskhvedadzee/ECE-Arcade/Cabinet/CNC/side-split-top-2.dxf

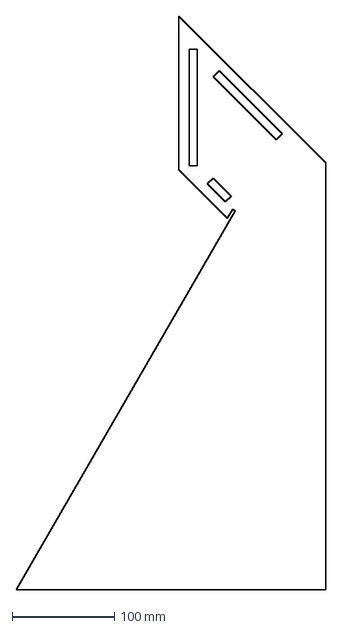
[picture p73: CAD file, 2026-08-28]
Cabinet/CNC/side-split-top-2.dxf
302.0 x 560.2 mm
