tskhvedadzee/ECE-Arcade/Cabinet/Laser/dxf/horn-side.DXF

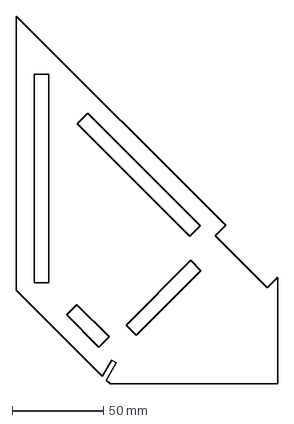
[picture p74: CAD file, 2026-08-28]
Cabinet/Laser/dxf/horn-side.DXF
143.1 x 201.3 mm
