tskhvedadzee/ECE-Arcade/Cabinet/Printing/ac-adapter-holder.3MF

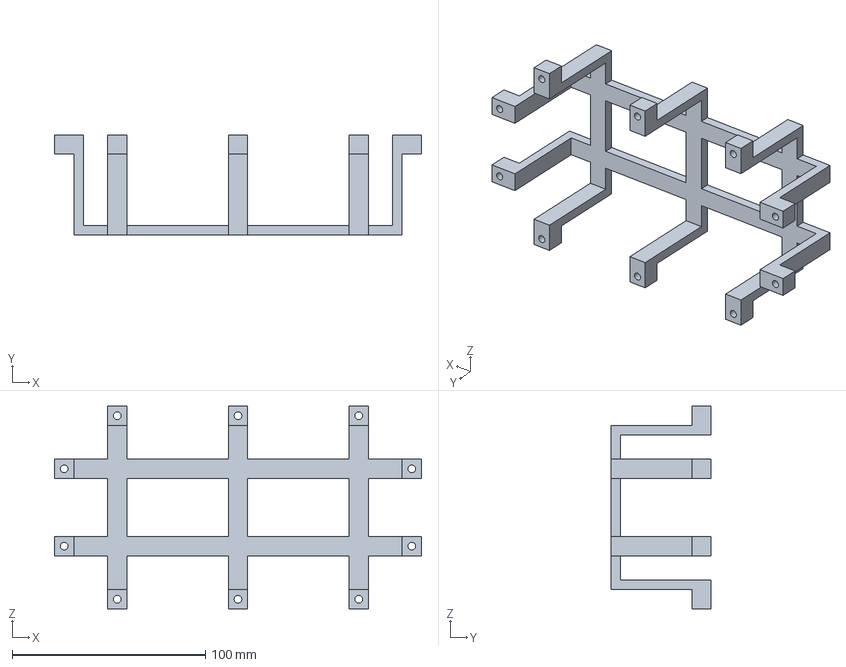
[picture p75: CAD file, 2026-08-28]
Cabinet/Printing/ac-adapter-holder.3MF
190.0 x 52.0 x 105.0 mm
