tskhvedadzee/ECE-Arcade/Cabinet/CAD/Body/horn-top.SLDPRT

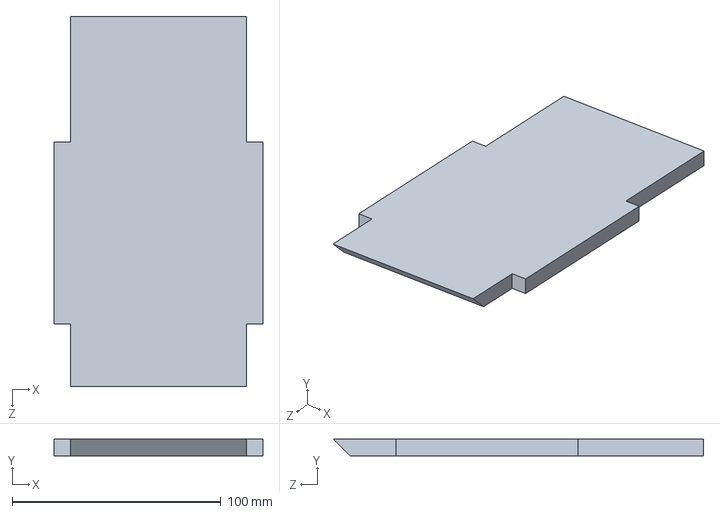
[picture p76: CAD file, 2026-08-11]
Cabinet/CAD/Body/horn-top.SLDPRT
100.0 x 8.00 x 177.2 mm
