tskhvedadzee/ECE-Arcade/Cabinet/CNC/top.DXF

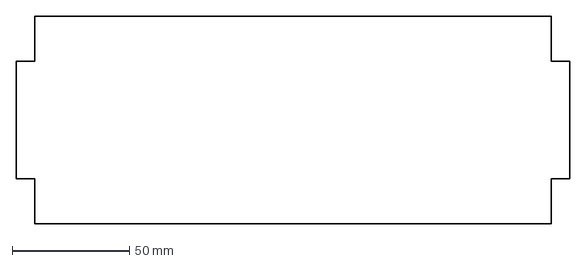
[picture p77: CAD file, 2026-08-28]
Cabinet/CNC/top.DXF
236.0 x 88.2 mm
