tskhvedadzee/ECE-Arcade/Cabinet/Printing/speaker-holder.3MF

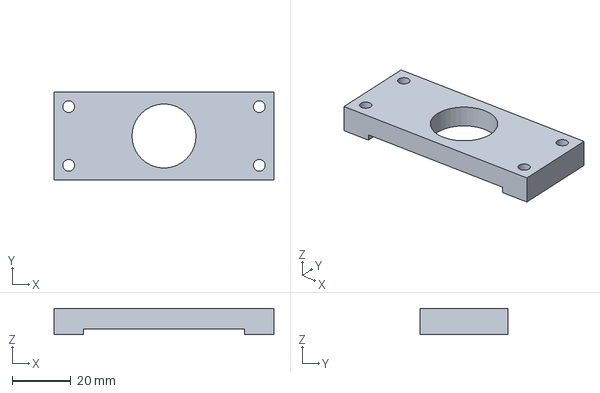
[picture p78: CAD file, 2026-08-28]
Cabinet/Printing/speaker-holder.3MF
75.0 x 30.0 x 9.00 mm
