tskhvedadzee/ECE-Arcade/Cabinet/CAD/Body/Bottom.SLDPRT

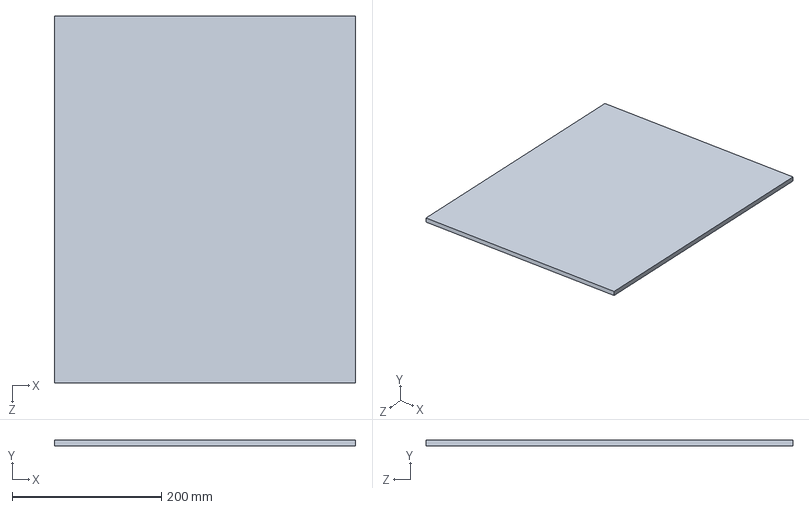
[picture p79: CAD file, 2026-08-08]
Cabinet/CAD/Body/Bottom.SLDPRT
404.0 x 8.00 x 492.0 mm
