tskhvedadzee/ECE-Arcade/Cabinet/CNC/horn-side.DXF

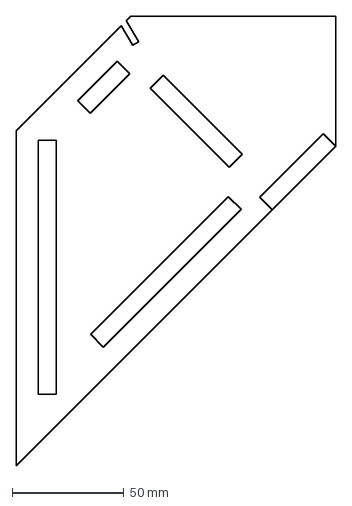
[picture p80: CAD file, 2026-08-28]
Cabinet/CNC/horn-side.DXF
143.1 x 201.3 mm
