tskhvedadzee/ECE-Arcade/Cabinet/CNC/back.DXF

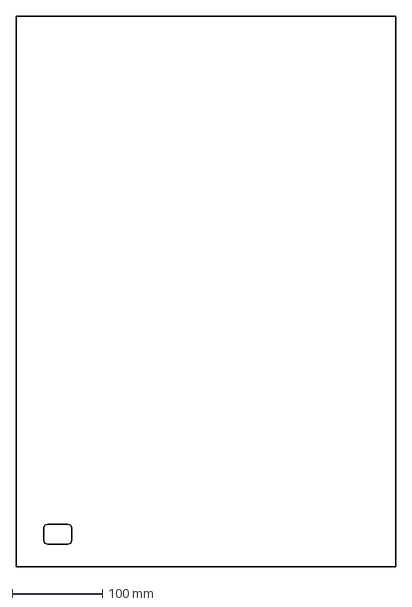
[picture p81: CAD file, 2026-08-28]
Cabinet/CNC/back.DXF
420.0 x 609.0 mm
