tskhvedadzee/ECE-Arcade/Cabinet/CNC/screen-front-cover.DXF

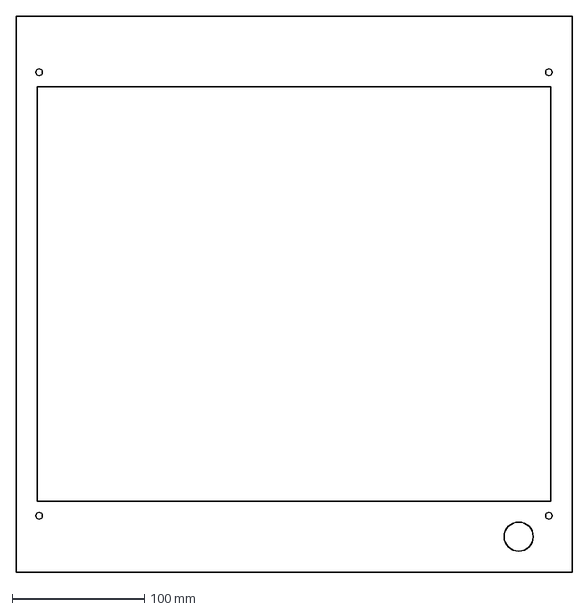
[picture p82: CAD file, 2026-08-28]
Cabinet/CNC/screen-front-cover.DXF
420.0 x 420.0 mm
