tskhvedadzee/ECE-Arcade/Cabinet/CNC/top-back.DXF

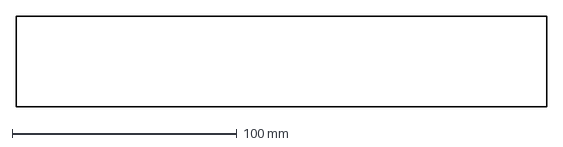
[picture p83: CAD file, 2026-08-28]
Cabinet/CNC/top-back.DXF
236.0 x 40.3 mm
