tskhvedadzee/ECE-Arcade/Cabinet/CNC/bottom.DXF

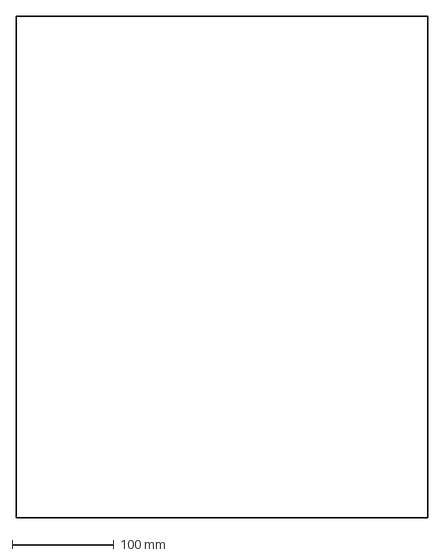
[picture p84: CAD file, 2026-08-28]
Cabinet/CNC/bottom.DXF
404.0 x 492.0 mm
