tskhvedadzee/ECE-Arcade/Cabinet/CNC/side-split-top.dxf

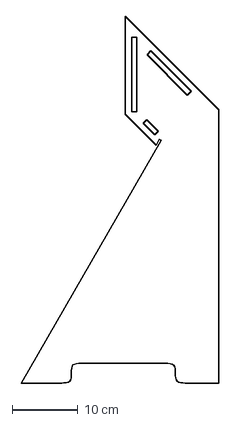
[picture p85: CAD file, 2026-08-28]
Cabinet/CNC/side-split-top.dxf
30.2 x 56.0 cm
