tskhvedadzee/ECE-Arcade/Cabinet/CAD/PAM8610_classD_12V_2x15W v6_.SLDASM

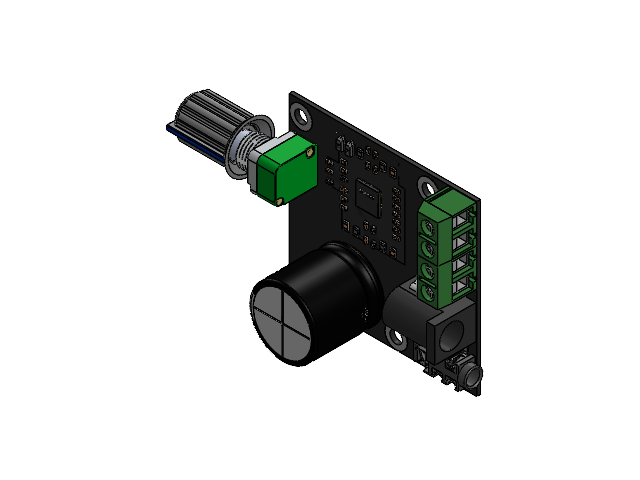
[picture p86: CAD file, 2026-08-11]
Cabinet/CAD/PAM8610_classD_12V_2x15W v6_.SLDASM
Body_bottom_plastic.step
Body_top_plastic.step
Body_tighter.step
Body003.step
Body004.step
Body_tighter001.step
Body_screw1.step
Body_screw2.step
Body_bottom_plastic (1).step
Body_top_plastic (1).step
Body_tighter (1).step
Body003 (1).step
Body004 (1).step
Body_tighter001 (1).step
Body_screw1 (1).step
Body_screw2 (1).step
PAM8610 Board_PAM8610 Amplifier Board.step
PAM8610_PAM8610 Amplifier Board.step
CAP_0603_PAM8610 Amplifier Board.step x 22
RES_0603_PAM8610 Amplifier Board.step x 2
CAP_0805_PAM8610 Amplifier Board.step x 3
L_0805_PAM8610 Amplifier Board.step x 4
D-SOD123_PAM8610 Amplifier Board.step x 2
board.step
2200uF 50V electr 18 x35mm -P.diameter 9mm-Black_Yellow.step
RD901F-20-15R1.step
10038075.step
Jack 12V DC v1.step
KNOB v1.step
