tskhvedadzee/ECE-Arcade/Cabinet/CAD/Body/Body.SLDASM

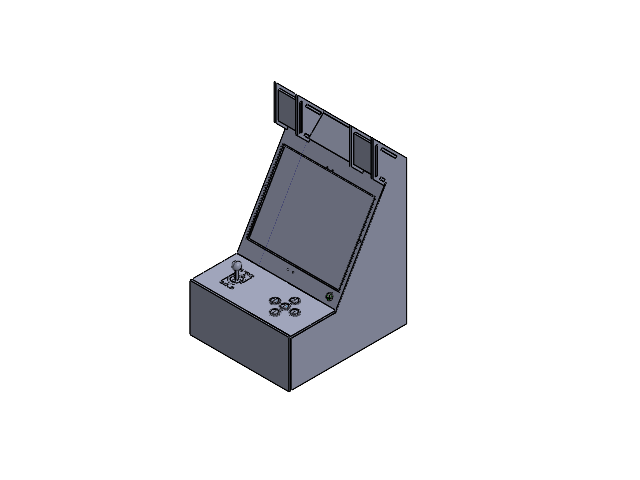
[picture p87: CAD file, 2026-09-12]
Cabinet/CAD/Body/Body.SLDASM
Bottom
front-front
side x 2
front-top
screen-front-cover
SANWA_JOYSTICK_3.stp
SSANWA_JOYSTICK_6.stp
SANWA_JOYSTICK_2.stp
SANWA_JOYSTICK_5.stp
GT-Y.stp
SANWA_JOYSTICK_0.stp
BALL.stp
DUSTER.stp
E.stp
SANWA_BUTTON_00.stp x 5
BLACK_00.stp x 5
SANWA_BUTTON_02.stp x 5
SPRING_4U_AF0.stp x 5
screen
screen-mount
push-button-switch-22mm
C14-power-socket-male
horn-side x 2
horn-bottom x 2
horn-front x 2
horn-top x 2
top
top-back
