tskhvedadzee/ECE-Arcade/Cabinet/CAD/5mm-LED.SLDASM

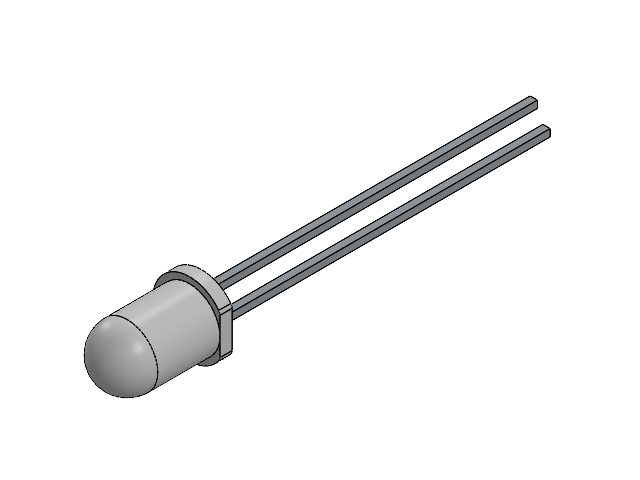
[picture p88: CAD file, 2026-08-11]
Cabinet/CAD/5mm-LED.SLDASM
Transparent Bulb.stp
Cathode.stp
Anode.stp
Semiconductor Pill.stp
Onner_Conductor.stp
