tskhvedadzee/ECE-Arcade/Cabinet/CAD/sanwa-joystick.SLDASM

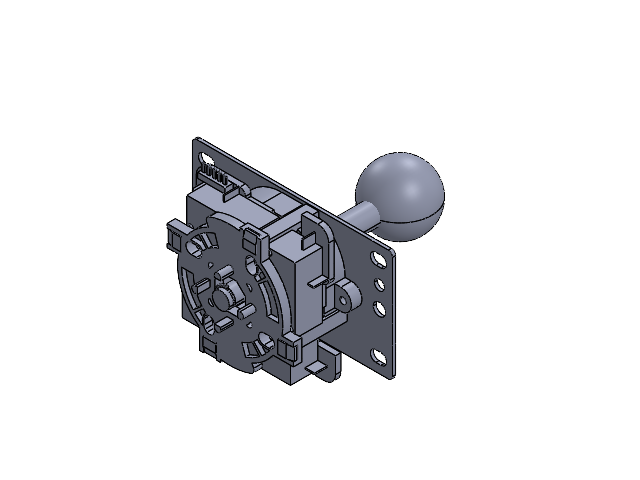
[picture p89: CAD file, 2026-08-08]
Cabinet/CAD/sanwa-joystick.SLDASM
SANWA_JOYSTICK_3.stp
SSANWA_JOYSTICK_6.stp
SANWA_JOYSTICK_2.stp
SANWA_JOYSTICK_5.stp
GT-Y.stp
SANWA_JOYSTICK_0.stp
BALL.stp
DUSTER.stp
E.stp
