tskhvedadzee/ECE-Arcade/Cabinet/CAD/sanwa-button-24mm.SLDASM

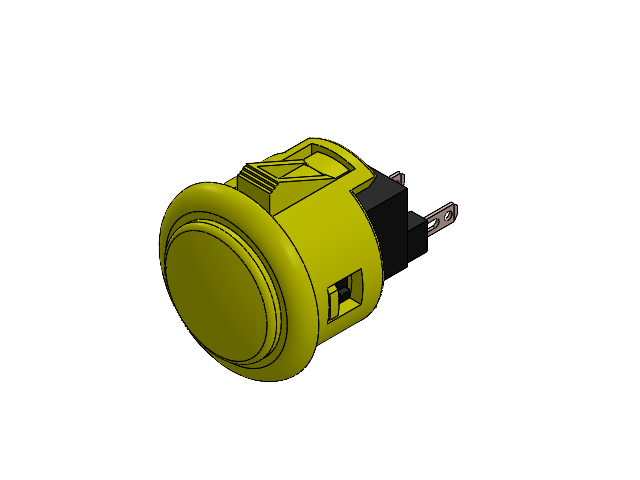
[picture p90: CAD file, 2026-08-08]
Cabinet/CAD/sanwa-button-24mm.SLDASM
Base.step
microswitch v2.step
Top cap.step
