tskhvedadzee/ECE-Arcade/Cabinet/CAD/sanwa-button-30mm.SLDASM

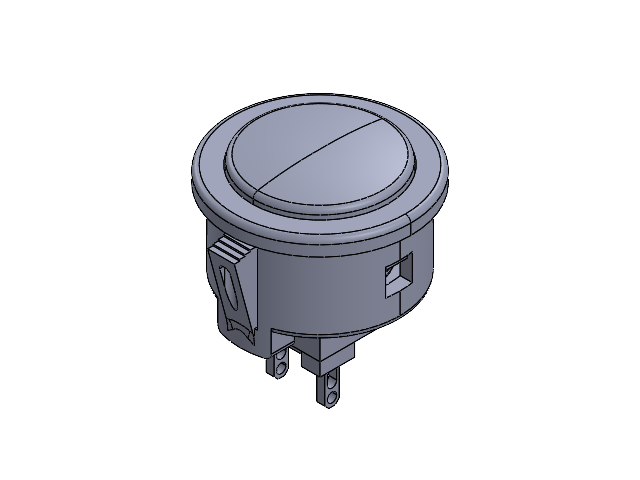
[picture p91: CAD file, 2026-08-08]
Cabinet/CAD/sanwa-button-30mm.SLDASM
SANWA_BUTTON_00.stp
BLACK_00.stp
SANWA_BUTTON_02.stp
SPRING_4U_AF0.stp
