tskhvedadzee/ECE-Arcade/(list of files, cad)

Other CAD files:
Cabinet/CAD/Cabinet.SLDASM
Cabinet/CAD/Holders/potentiometer-knob.SLDPRT
Cabinet/Printing/screen-IR-holder-side.3MF
Gun-V2/CAD/Test/fit_test_esp32_right.stl
Cabinet/Printing/wire-clip-2x.3MF
Cabinet/Printing/wire-clip-8x.3MF
Cabinet/CAD/Holders/wire-clip-4x.SLDPRT
Cabinet/CAD/Holders/buck-holder.SLDPRT
Cabinet/CAD/Holders/magnet-holder-inner.SLDPRT
Cabinet/CAD/Holders/magnet-holder-outer.SLDPRT
Cabinet/CAD/Holders/8mm corner.SLDPRT
Cabinet/CAD/Holders/ac-adapter-holder.SLDPRT
Cabinet/Printing/6mm corner.3MF
Cabinet/CAD/Holders/speaker-holder.SLDPRT
Cabinet/CAD/5mm-LED.SLDPRT
Cabinet/CAD/Holders/screen-IR-holder-side.SLDPRT
Cabinet/CNC/front-top.DXF
Gun-V2/CAD/STEP/gun_left_half-v10.step
Gun-V2/CAD/STEP/gun_left_half-v11.step
Gun-V2/CAD/STEP/gun_right_half-v10.step
Gun-V2/CAD/STEP/gun_right_half-v11.step
Gun-V2/CAD/STEP/gun_right_half-v12.step
Gun-V2/CAD/STL/gun_left_half.stl
Gun-V2/CAD/STL/gun_right_half.stl
Gun-V2/CAD/STL/mosfet_clip.stl
Gun-V2/CAD/STL/trigger.stl
Gun/CAD/DFrobot_SEN0158_IR_Camera.SLDASM
Gun/CAD/Gun-v2.SLDASM
Gun/CAD/Gun.SLDASM
Gun/CAD/battery-holder.SLDPRT
Gun/CAD/outer-shell-left-v2.SLDPRT
Gun/CAD/outer-shell-left.SLDPRT
Gun/CAD/outer-shell-right-v2.SLDPRT
Gun/CAD/outer-shell-right.SLDPRT
Gun/CAD/trigger-test.SLDPRT
Gun/Printing/outer-shell-left.3MF
Gun/Printing/outer-shell-right.3MF
Gun/Printing/trigger-test.3MF
