tskhvedadzee/ECE-Arcade/Gun-V2/Photos/Final-Print/89C88142-480B-4F68-A5F0-EB13A1006A36.JPG

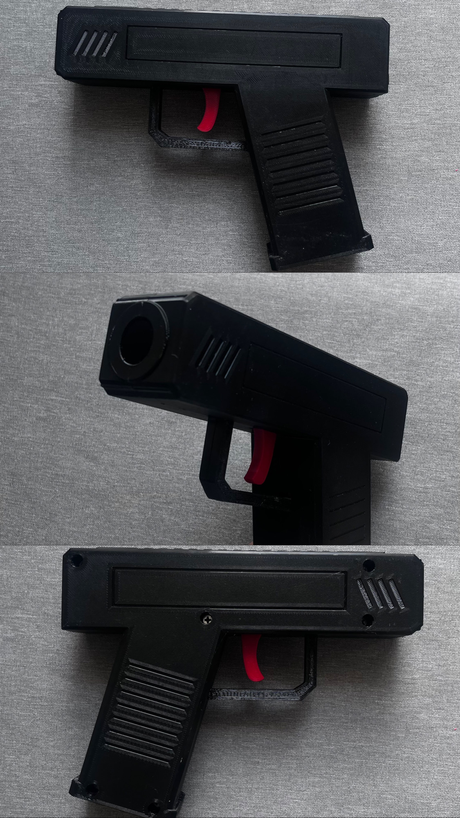
Gun-V2/Photos/Final-Print/89C88142-480B-4F68-A5F0-EB13A1006A36.JPG
