tskhvedadzee/ECE-Arcade/Gun-V2/Photos/Final-Print/IMG_3332.jpg

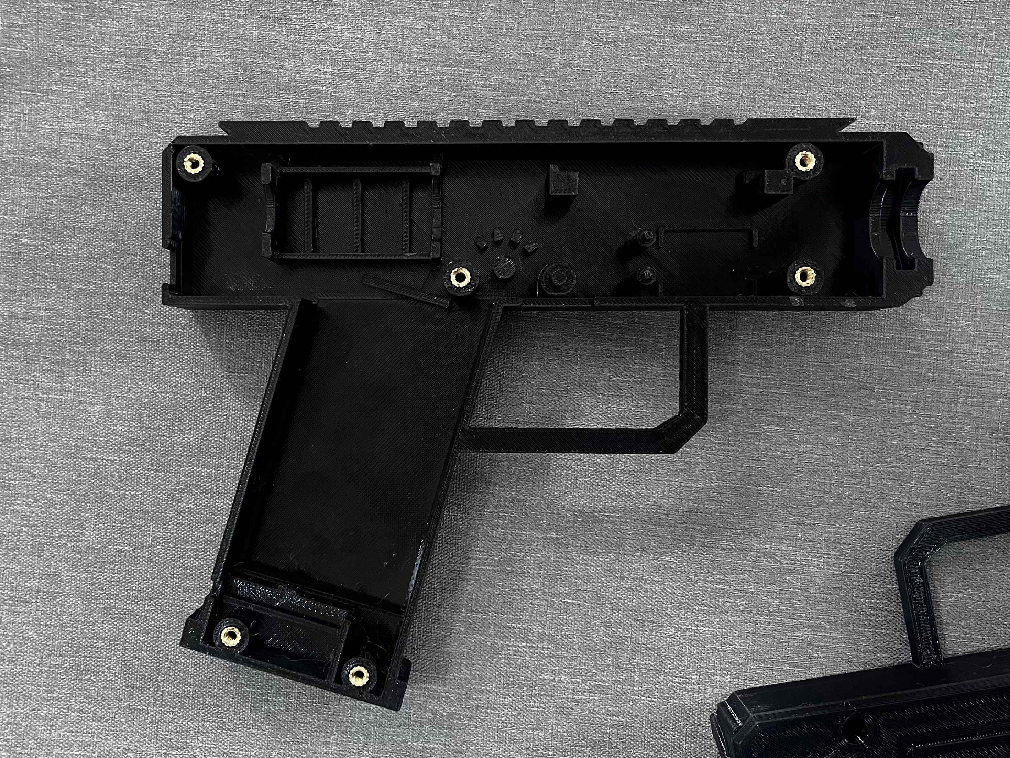
Gun-V2/Photos/Final-Print/IMG_3332.jpg
