tskhvedadzee/ECE-Arcade/Gun-V2/Photos/Final-Print/IMG_3412.jpg

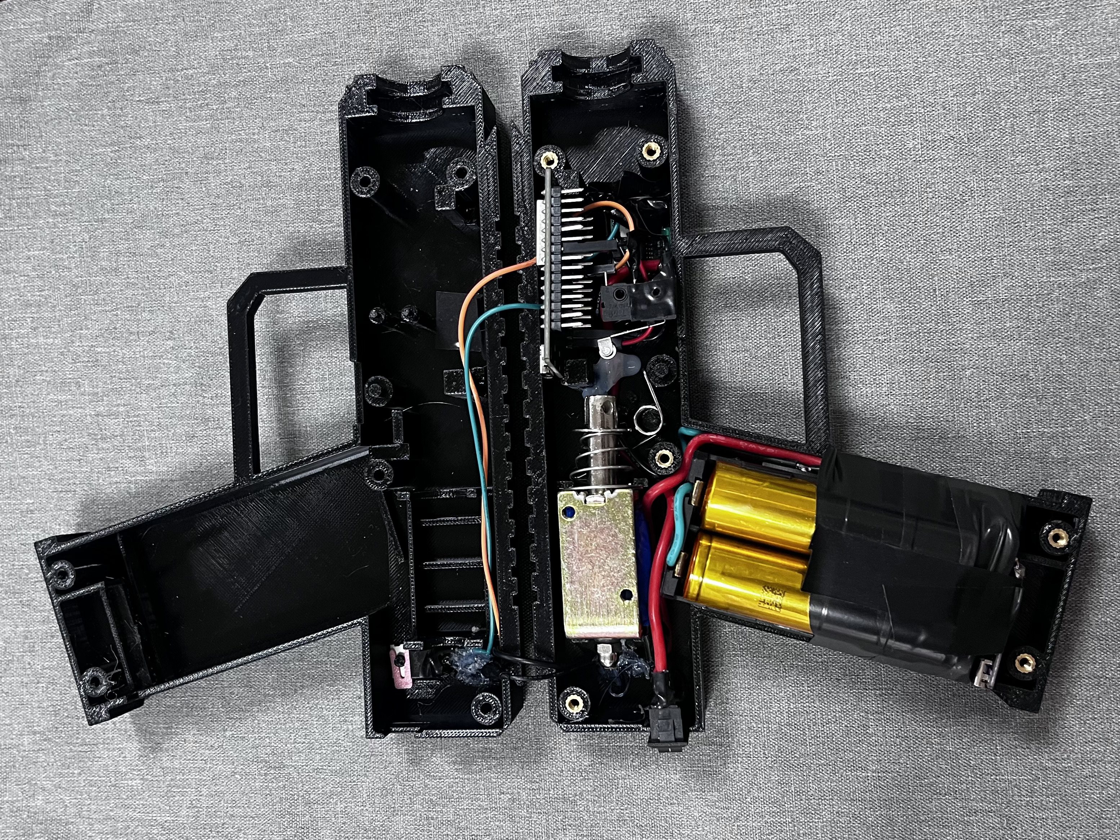
Gun-V2/Photos/Final-Print/IMG_3412.jpg
