tskhvedadzee/ECE-Arcade/Gun-V2/Photos/Final-Print/IMG_3481.jpg

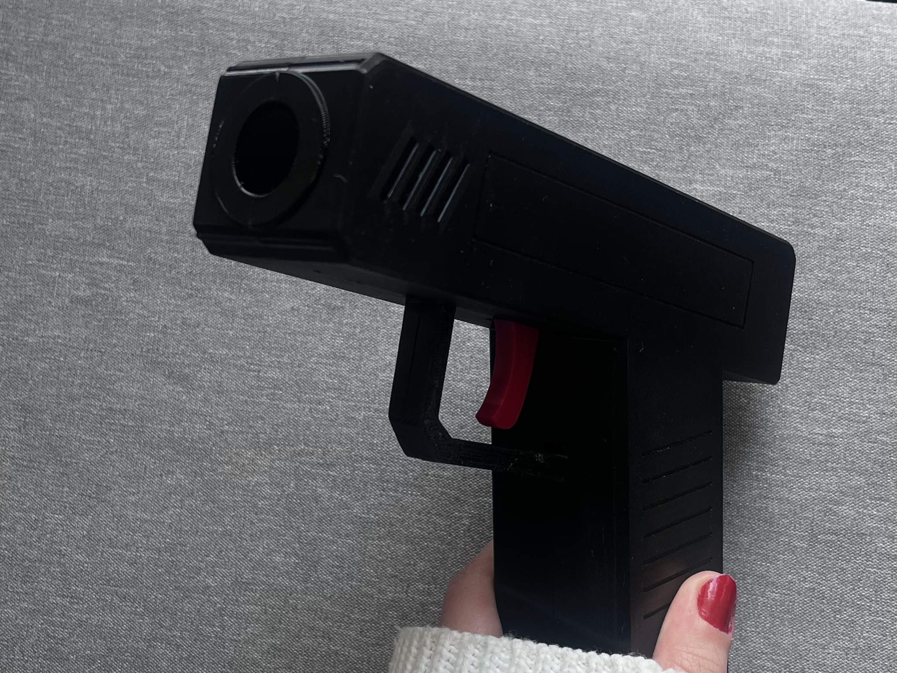
Gun-V2/Photos/Final-Print/IMG_3481.jpg
