tskhvedadzee/ECE-Arcade/Gun-V2/Photos/Test-Prints/photo1.jpg

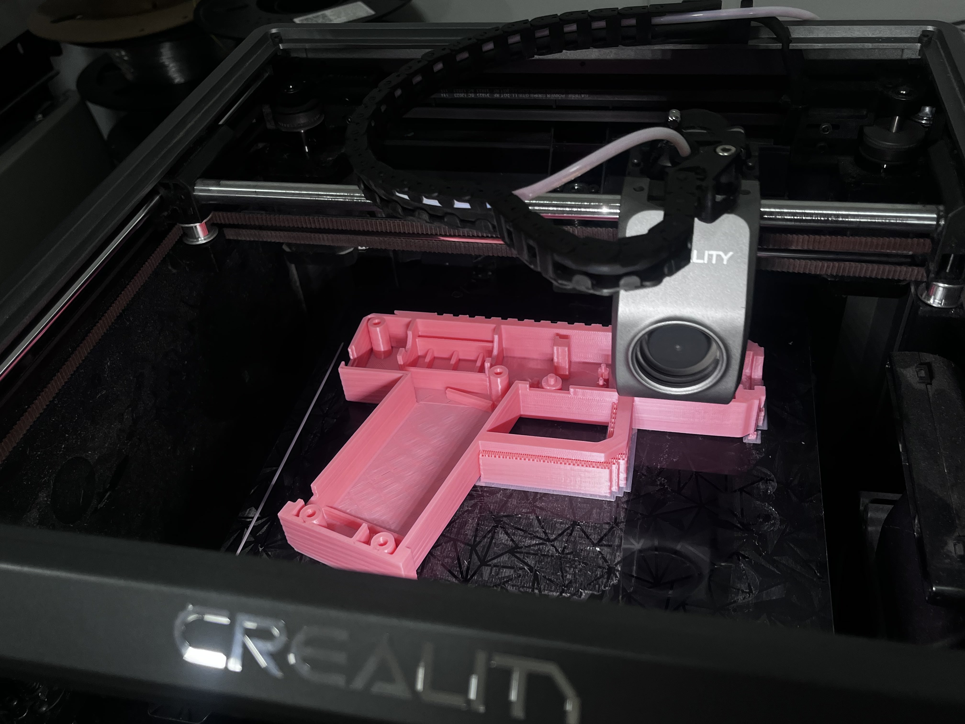
Gun-V2/Photos/Test-Prints/photo1.jpg
