tskhvedadzee/ECE-Arcade/Gun-V2/Photos/Test-Prints/photo2.jpg

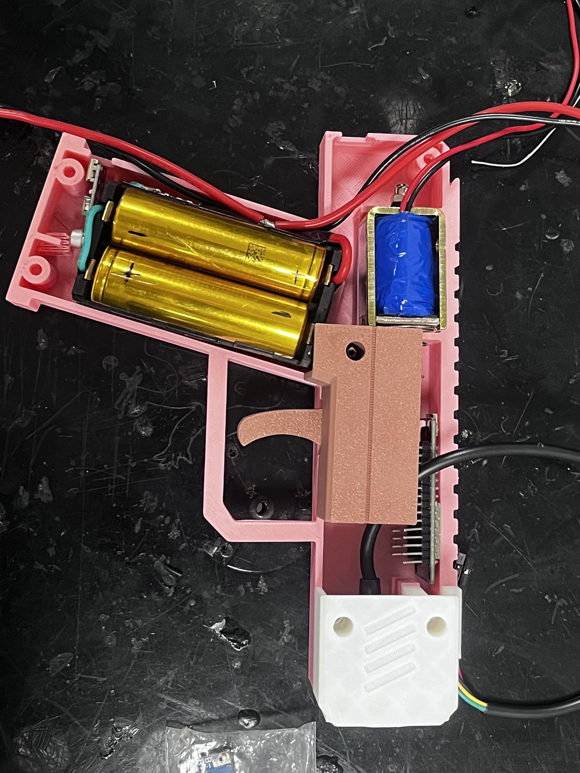
Gun-V2/Photos/Test-Prints/photo2.jpg
