tskhvedadzee/ECE-Arcade/Gun-V2/Photos/Test-Prints/photo3.png

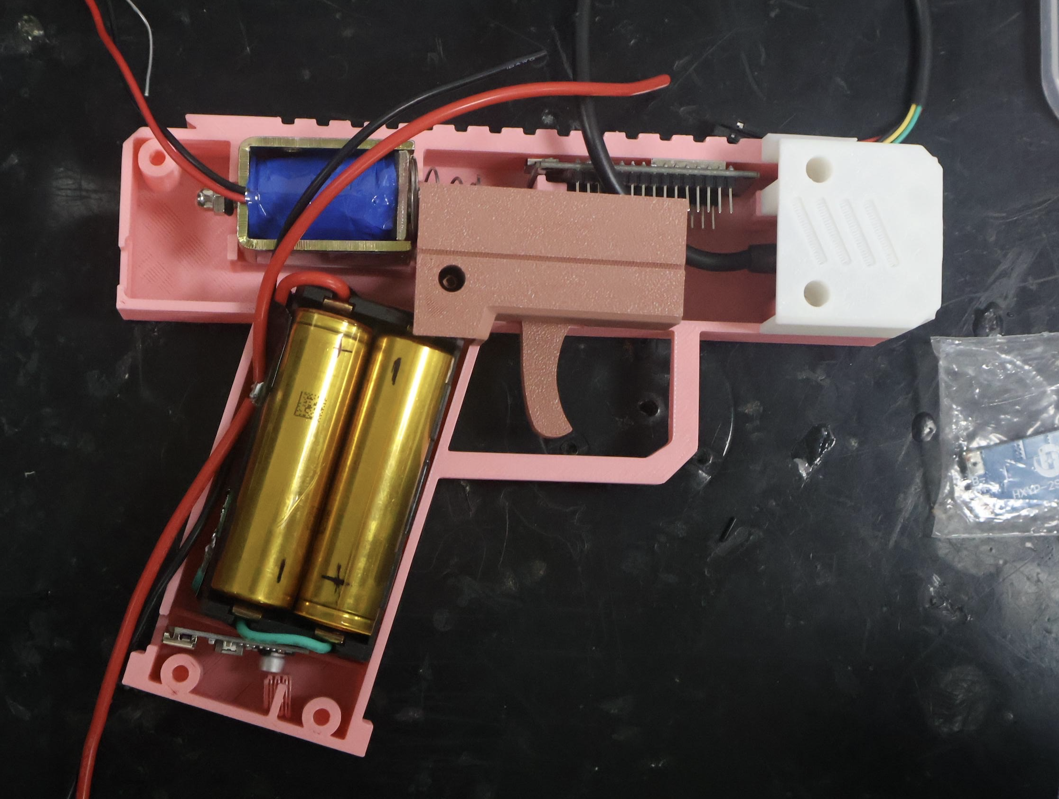
Gun-V2/Photos/Test-Prints/photo3.png
