tskhvedadzee/ECE-Arcade/Gun-V2/Photos/Test-Prints/photo4.jpg

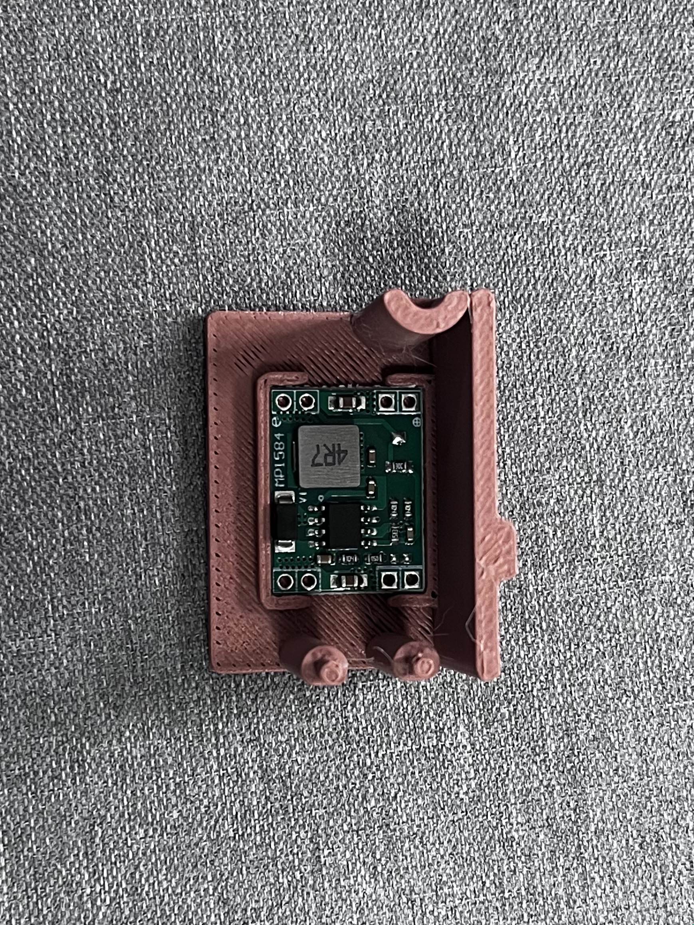
Gun-V2/Photos/Test-Prints/photo4.jpg
