tskhvedadzee/ECE-Arcade/Gun-V2/Photos/Test-Prints/photo5.jpg

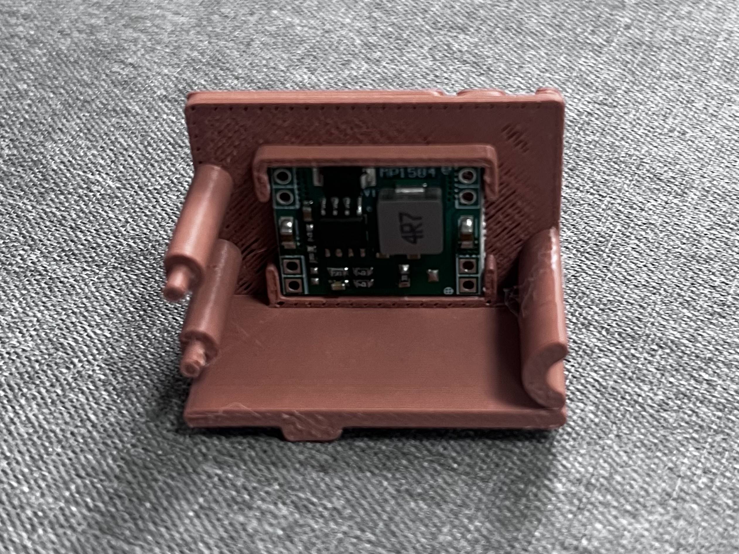
Gun-V2/Photos/Test-Prints/photo5.jpg
