tskhvedadzee/ECE-Arcade/Gun-V2/Photos/Test-Prints/photo6.jpg

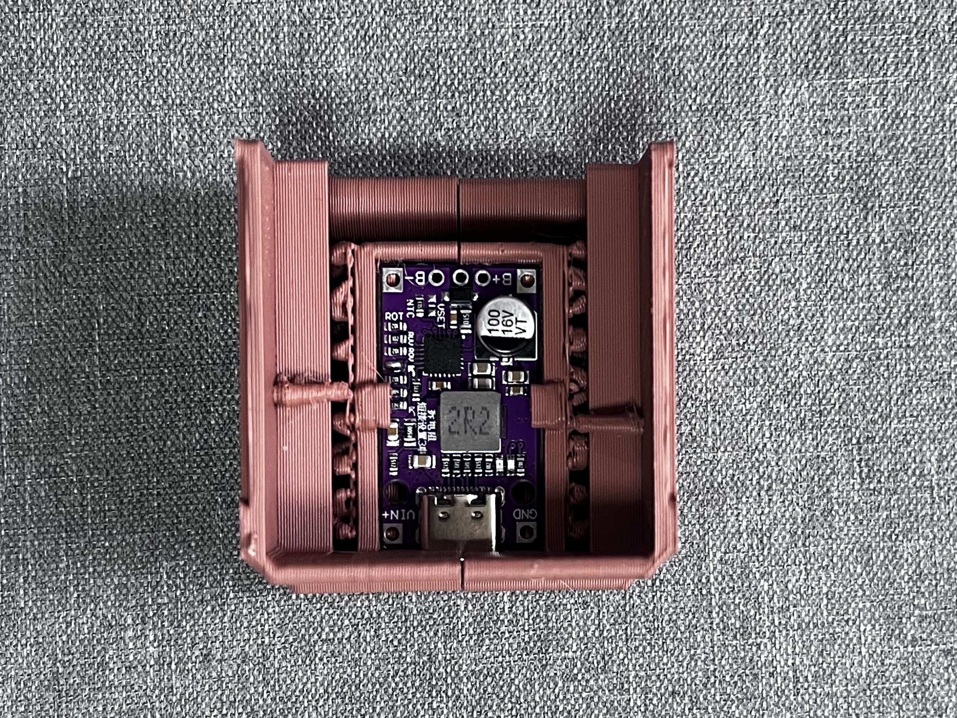
Gun-V2/Photos/Test-Prints/photo6.jpg
