tskhvedadzee/ECE-Arcade/Gun-V2/Photos/Test-Prints/photo7.jpg

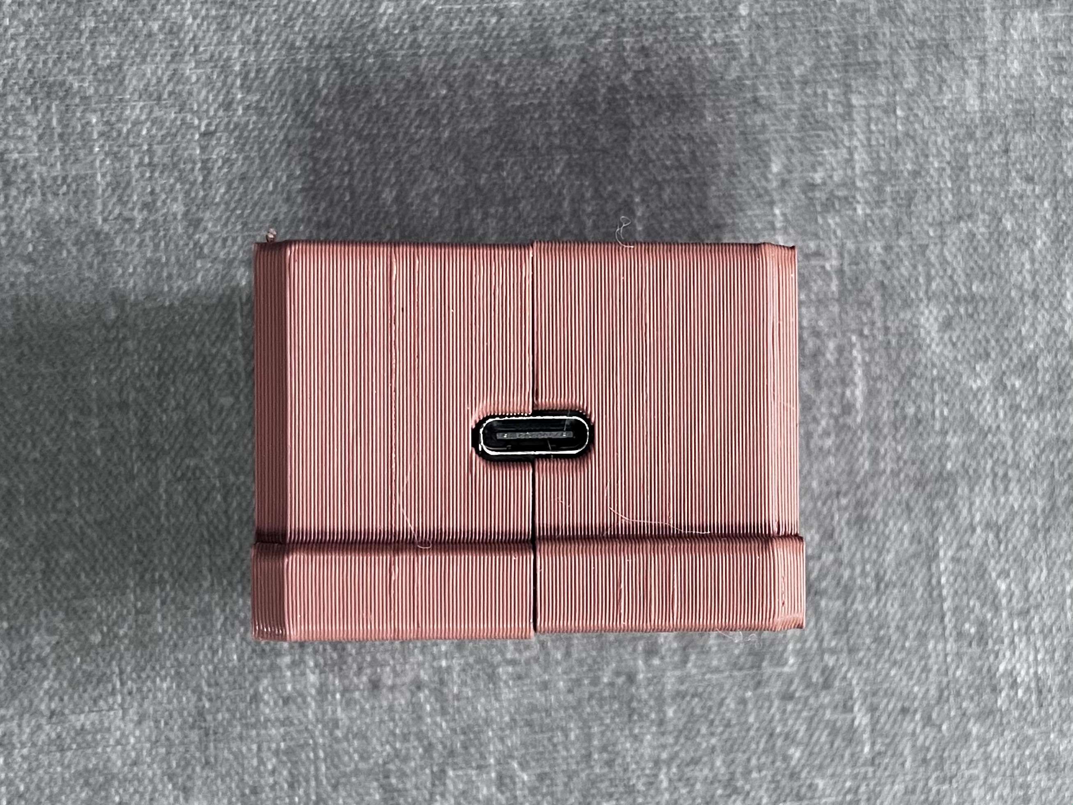
Gun-V2/Photos/Test-Prints/photo7.jpg
