tskhvedadzee/ECE-Arcade/Gun-V2/Firmware/include/config.h

#pragma once

#include <stdint.h>

#include "geometry.h"

namespace config {

// Pins for an ESP32-WROOM-32 dev board, as wired in the Gun-V2 schematic.
// Avoided for future additions: GPIO 6-11 (flash), 0/2/12/15 (strapping),
// 16/17 (PSRAM on WROVER modules), 34-39 (input only, no pull-ups).
constexpr int kPinSda = 21;
constexpr int kPinScl = 22;
constexpr int kPinTrigger = 18;   // microswitch COM, NO to ground
constexpr int kPinSolenoid = 33;  // IRLZ44N gate via 100 ohm, 10 kohm pull-down

constexpr uint32_t kI2cClockHz = 400000;

// LED positions in normalised screen coordinates, measured from the edge of
// the visible image. Values outside 0..1 are on the bezel.
constexpr Point2 kLedScreen[kLedCount] = {
    {0.500f, -0.048f},  // top,    14.33 mm above a 301.1 mm tall image
    {1.037f, 0.500f},   // right,  14 mm outside a 376.3 mm wide image
    {0.500f, 1.065f},   // bottom, 19.67 mm below
    {-0.037f, 0.500f},  // left,   14 mm outside
};

// True if the camera image is mirrored relative to the barrel on that axis.
constexpr bool kCameraFlipX = false;
constexpr bool kCameraFlipY = true;

// Radio. Channel and gun ID must match the receiver.
constexpr uint8_t kRadioChannel = 1;
constexpr uint8_t kGunId = 1;
constexpr uint32_t kKeepAliveMs = 5;

// Feedback and input timing.
constexpr uint32_t kSolenoidPulseMs = 35;
constexpr uint32_t kDebounceMs = 15;

// Exponential smoothing factor for the cursor; 1.0 disables smoothing.
constexpr float kSmoothing = 1.0f;

// Firmware updates over the air. Holding the trigger at power-on for this
// long starts an access point and waits for an upload instead of running
// normally. The password must be at least 8 characters for WPA2.
constexpr uint32_t kOtaHoldMs = 5000;
constexpr char kOtaSsid[] = "GunV2-Update";
constexpr char kOtaPassword[] = "lightgun";
constexpr char kOtaHostname[] = "gun-v2";

constexpr bool kSerialDebug = true;
constexpr uint32_t kDebugIntervalMs = 100;

}  // namespace config
