tskhvedadzee/ECE-Arcade/(commit log)

2026-08-08 started cabinet body design
    [Body.SLDASM, Bottom.SLDPRT, Cabinet.SLDASM, back.SLDPRT, front-front.SLDPRT, front-top.SLDPRT, sanwa-button-24mm.SLDASM, sanwa-button-30mm.SLDASM]
2026-08-11 added body 3d model
    [5mm-LED.SLDASM, 5mm-LED.SLDPRT, Body.SLDASM, C14-power-socket-male.SLDPRT, PAM8610_classD_12V_2x15W v6_.SLDASM, back.SLDPRT, front-top.SLDPRT, horn-bottom.SLDPRT]
2026-08-12 add lasercut parts
    [back.DXF, bottom.DXF, front-top.DXF, front.DXF, horn-bottom.DXF, horn-front.DXF, horn-side.DXF, horn-top.DXF]
2026-08-12 add 3d printable holders
    [8mm corner.3MF, 8mm corner.SLDPRT, speaker-holder.SLDPRT, speaker-holder.step]
2026-08-20 add cnc files
    [back.DXF, bottom.DXF, front-front.DXF, front-top.DXF, horn-bottom.DXF, horn-front.DXF, horn-side.DXF, horn-top.DXF]
2026-08-20 finalised body design
    [Body.SLDASM, back.SLDPRT, front-front.SLDPRT, front-top.SLDPRT, horn-side.SLDPRT, screen-mount.SLDPRT, side.SLDPRT]
2026-08-20 started gun design
    [Gun.SLDASM, trigger-test.3MF, trigger-test.SLDPRT]
2026-08-28 add helper part 3d models
    [6mm corner.3MF, 8mm corner.3MF, 8mm corner.SLDPRT, ac-adapter-holder.3MF, ac-adapter-holder.SLDPRT, speaker-holder.3MF, speaker-holder.SLDPRT]
2026-08-28 add gun parts
    [DFrobot_SEN0158_IR_Camera.SLDASM]
2026-08-31 add wire clips
    [wire-clip-2x.3MF, wire-clip-2x.SLDPRT, wire-clip-4x.3MF, wire-clip-4x.SLDPRT, wire-clip-8x.3MF, wire-clip-8x.SLDPRT]
2026-08-31 add holders
    [buck-holder.3MF, buck-holder.SLDPRT, magnet-holder-inner.SLDPRT, magnet-holder-outer.3MF, magnet-holder-outer.SLDPRT, speaker-holder.step]
2026-08-31 add gun outer shell
    [Gun.SLDASM, outer-shell-left.3MF, outer-shell-left.SLDPRT, outer-shell-right.3MF, outer-shell-right.SLDPRT]
2026-08-31 modified front top to have more buttons
    [front-top-v2.dxf, front-top.SLDPRT.DXF]
2026-08-31 add raspberry holders
    [raspberry-holder-bottom.stl, raspberry-holder-top.stl]
2026-08-31 remove unnecessary files
    [trigger-test.3MF]
2026-08-31 add platformio project
    [magnet-holder-inner.SLDPRT, magnet-holder-outer.SLDPRT]
2026-08-31 Add battery holder CAD
    [battery-holder.SLDPRT]
2026-09-12 Gun-v2/Add front fit test parts
    [fit_test_front_left.stl, fit_test_front_right.stl]
2026-09-12 Gun-v2/add gun STL files
    [gun_left_half.stl, gun_right_half.stl]
2026-09-12 Gun-v2/add gun STEP files
    [gun_left_half.step, gun_right_half.step]
2026-09-12 Gun-V2/Replace kit trigger with a printed trigger
    [fit_test_trigger_left.stl, fit_test_trigger_right.stl, trigger.step, trigger.stl]
2026-09-12 Gun-v2/update gun sides step and stl files with new trigger
    [gun_left_half-v2.step, gun_left_half-v2.stl, gun_right_half-v2.step, gun_right_half-v2.stl]
2026-09-12 modified led holder
    [Body1.SLDPRT, Body2.SLDPRT, LED-holder-60deg-bottom.3MF, LED-holder-60deg-bottom.SLDPRT, LED-holder-65deg-bottom.3MF, LED-holder-65deg-bottom.SLDPRT, LED-holder-70deg-bottom.3MF, LED-holder-70deg-bottom.SLDPRT]
2026-09-12 Gun-v2/resize power switch opening
    [gun_left_half-v2.step, gun_left_half-v2.stl, gun_left_half-v3.step, gun_left_half-v3.stl, gun_right_half-v2.step, gun_right_half-v2.stl, gun_right_half-v3.step, gun_right_half-v3.stl]
2026-09-12 modify side IR holder
    [screen-IR-holder-side.SLDPRT]
2026-09-12 horizontal IR holder for screen
    [screen-IR-holder-horizontal.3MF, screen-IR-holder-horizontal.SLDPRT]
2026-09-12 fix screen front cover IR led layout
    [Body.SLDASM, front-top.SLDPRT, horn-side.SLDPRT, screen-front-cover-2.DXF, screen-front-cover.SLDPRT, side.SLDPRT]
2026-09-18 Gun-v2/fix trigger roller switch measurements
    [fit_test_trigger_left-v2.stl, fit_test_trigger_left.stl, fit_test_trigger_right-v2.stl, fit_test_trigger_right.stl, gun_left_half-v3.stl, gun_left_half-v4.step, gun_left_half-v4.stl, gun_right_half-v3.stl]
2026-09-18 Gun-v2/thicken and shorten the spring post and reposition solenoid to avoid collision
    [fit_test_trigger_left-v2.stl, fit_test_trigger_left-v3.stl, fit_test_trigger_right-v2.stl, fit_test_trigger_right-v3.stl, gun_left_half-v4.stl, gun_left_half-v5.step, gun_left_half-v5.stl, gun_right_half-v4.stl]
2026-09-18 Gun-v2/resize grip to fit battery pack better
    [gun_left_half-v5.stl, gun_left_half-v6.step, gun_left_half-v6.stl, gun_right_half-v5.stl, gun_right_half-v6.step, gun_right_half-v6.stl]
2026-09-18 Gun-v2/test pieces made cheaper to print
    [fit_test_trigger_left-v3.stl, fit_test_trigger_left.stl, fit_test_trigger_right-v3.stl, fit_test_trigger_right.stl]
2026-09-18 Gun-v2/measurements adjusments
    [gun_left_half-v6.step, gun_left_half-v6.stl, gun_left_half-v7.step, gun_left_half-v7.stl, gun_right_half-v6.stl, gun_right_half-v7.step, gun_right_half-v7.stl]
2026-09-21 Gun-v2/fix charger opening and add test prints for it
    [fit_test_butt_left.stl, fit_test_butt_right.stl, gun_left_half-v7.step, gun_left_half-v7.stl, gun_left_half-v8.step, gun_left_half-v8.stl, gun_right_half-v7.step, gun_right_half-v7.stl]
2026-09-21 Gun-v2/adjust esp32 measurements
    [fit_test_esp32_left.stl, fit_test_esp32_right.stl, gun_left_half-v8.step, gun_left_half-v8.stl, gun_left_half-v9.step, gun_left_half-v9.stl, gun_right_half-v8.stl, gun_right_half-v9.step]
2026-09-21 add magnet holder print files
    [magnet-holder-inner.3MF, magnet-holder-outer.3MF]
2026-09-21 add potentiometer knob
    [potentiometer-knob.3MF, potentiometer-knob.SLDPRT]
2026-09-21 Update screen IR holder
    [screen-IR-holder-horizontal.SLDPRT]
2026-09-23 Gun-v2/Add buck converter in gun and test print for it
    [fit_test_buck.stl, gun_left_half-v10.step, gun_left_half-v10.stl, gun_left_half-v9.step, gun_left_half-v9.stl, gun_right_half-v10.step, gun_right_half-v10.stl, gun_right_half-v9.step]
2026-09-23 Gun-v2/clean out some space for wires above solenoid
    [gun_left_half-v10.stl, gun_left_half-v11.step, gun_left_half-v11.stl, gun_right_half-v11.step, gun_right_half-v11.stl]
2026-09-23 Gun-v2/add mosfet holder and clip
    [fit_test_mosfet.stl, gun_left_half-12.step, gun_left_half-v11.stl, gun_left_half-v12.stl, gun_right_half-v11.stl, gun_right_half-v12.step, gun_right_half-v12.stl, mosfet_clip.step]
2026-09-23 Gun-v2/adjusdt heat insert hole sizes
    [gun_left_half-12.step, gun_left_half-v12.stl, gun_left_half.step, gun_left_half.stl, gun_right_half-v12.stl, gun_right_half.step, gun_right_half.stl, test_insert.stl]
2026-09-25 Fix receiver USB HID enumeration and FS include path
    [main.cpp]
2026-09-28 Recover the camera I2C bus after a fault, add measured LED positions
2026-09-28 Set measured LED positions and camera orientation for the 19-inch screen
2026-09-28 Gun-V2/add test print photos
2026-09-28 Gun-v2/final print and assembly photos
2026-09-28 Gun-v2/add test print photos with fixed format
2026-10-04 add amplifier holders
    [amp_bracket_long_across.step, amp_bracket_long_into_cabinet.step]
